Aerosol-Technology-Lab/IoT-Smart-Hydroponics-Greenhouse-Research/README.md

# IoT-Smart-Hydroponics-Greenhouse-Research
Smart Hydroponics Greenhouse for BAEN Research
