Aerosol-Technology-Lab/IoT-Smart-Hydroponics-Greenhouse-Research/pcb/mainboard-small/mainboard.xlsx

Prj: | Main | Hydroponics Mainboard |  |  |  |  | Board Qty: | 100
Co.: | Aerosol Technology Lab | Texas A&M University @ College Station, TX |  |  |  |  | Unit Cost: | $0.00
Prj date: | Fri 22 Oct 2021 12:01:29 PM CDT |  |  |  |  | Total Cost: | $0.00 |  |  |  |  | $0.00 | 0 of 42 parts found
$ date: | 2021-10-22 12:02:37
Global Part Info |  |  |  |  |  |  |  | Digi-Key
Refs | Value | Footprint | Manf | Manf# | Qty | Unit$ | Ext$ | Avail | Purch | Unit$ | MOQ | Ext$ | Cat#
C1-C3,C7-C9,C15 | 10uF | C_0805_2012Metric | CL21B106KOQNNNG |  | 700
C5,C11-C13,C16 | 0.1uF | C_0603_1608Metric | C0603C104J4RAC7867 | C0603C104J4RAC7867 | 500
H1,H2 | MountingHole | MountingHole_3.2mm_M3_ISO7380_Pad_TopOnly | - | - | 200
H3-H5 | MountingHole_Pad | MountingHole_3.2mm_M3_Pad_Via | - | - | 300
H6,H7 | MountingHole_Pad | MountingHole_4.3mm_M4_Pad_Via | - | - | 200
J1 | MC Comms Header | PinSocket_1x06_P2.54mm_Vertical | PPTC061LFBN-RC | PPTC061LFBN-RC | 100
J2 | 3.3V Breakout | PinSocket_1x08_P2.54mm_Vertical | - | - | 100
J3 | MC Digital HEADER | PinSocket_1x06_P2.54mm_Vertical | PPTC061LFBN-RC | PPTC061LFBN-RC (https://www.digikey.com/en/products/detail/sullins-connector-solutions/PPTC061LFBN-RC/810145) | 100
J4 | 5V Breakout | PinSocket_1x08_P2.54mm_Vertical | - | - | 100
J5 | MC_PWR | PinHeader_1x06_P2.54mm_Vertical | PPTC061LFBN-RC | PPTC061LFBN-RC | 100
J6 | MC Digital GPIO | PinSocket_1x06_P2.54mm_Vertical | PPTC061LFBN-RC | PPTC061LFBN-RC (https://www.digikey.com/en/products/detail/sullins-connector-solutions/PPTC061LFBN-RC/810145) | 100
J7 | GND Breakout | PinSocket_1x08_P2.54mm_Vertical |  | - | 100
J8 | MC Comms Breakout | PinHeader_1x06_P2.54mm_Vertical | PPTC061LFBN-RC | PPTC061LFBN-RC | 100
J9,J11 | BUS Breakout | PinHeader_2x04_P2.54mm_Vertical | - | - | 200
J10 | 5V Fan Header | PinHeader_1x02_P2.54mm_Vertical | - | - | 100
J12 | CP_2035551012 | MOLEX_2035551012 | 2035551012 | 2035551012 | 100
J13 | Chamber 1 | MTJ-889X1-FSE(RJ45) | MTJ-889X1-FSE | MODULAR JACK RJ45 8P8C | 100
J14 | Chamber 2 | MTJ-889X1-FSE(RJ45) | MTJ-889X1-FSE | MODULAR JACK RJ45 8P8C | 100
J15 | Chamber 3 | MTJ-889X1-FSE(RJ45) | MTJ-889X1-FSE | MODULAR JACK RJ45 8P8C | 100
J17 | RTC Module | PinSocket_1x06_P2.54mm_Vertical | PPTC061LFBN-RC | PPTC061LFBN-RC | 100
J18 | Raspberry Pi | IDC-Header_2x20_P2.54mm_Vertical | 3020-20-0100-00 | 3020-20-0100-00 | 100
J21 | +12V In | YK7010223000G(2POS-Terminal-Block) | YK7010223000G | YK7010223000G (https://www.digikey.com/en/htmldatasheets/production/1638528/0/0/1/yk701xx2x0j0g-drawing.html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) | 100
JP1 | SolderJumper_2_Open | SolderJumper-2_P1.3mm_Open_TrianglePad1.0x1.5mm | - | - | 100
JP2 | SCL_SELECT | SolderJumper-3_P1.3mm_Bridged12_Pad1.0x1.5mm | - | - | 100
JP3 | MC 3.3V | SolderJumper-2_P1.3mm_Bridged2Bar_Pad1.0x1.5mm | - | - | 100
JP4 | RPi-Reset_EN | SolderJumper-2_P1.3mm_Open_TrianglePad1.0x1.5mm | - | - | 100
JP5 | SDA_SELECT | SolderJumper-3_P1.3mm_Bridged12_Pad1.0x1.5mm | - | - | 100
JP6 | PI-RTC_PWR_EN | SolderJumper-2_P1.3mm_Open_TrianglePad1.0x1.5mm | - | - | 100
JP7 | Earth Ground-Signal Groud Bridge | SolderJumper-2_P1.3mm_Open_TrianglePad1.0x1.5mm | - | - | 100
JP8,JP9 | SolderJumper_2_Open | SolderJumper-2_P1.3mm_Open_Pad1.0x1.5mm | - | - | 200
Q1 | DMG3402L | SOT-23 | DMG3402L-7 | DMG3402L-7 (http://www.diodes.com/assets/Datasheets/DMG3402L.pdf) | 100
Q2 | RD3L07BAT | TO-252-2 | RD3L03BATTL1 | RD3L03BATTL1 (https://fscdn.rohm.com/en/products/databook/datasheet/discrete/transistor/mosfet/rd3l07battl1-e.pdf) | 100
R1,R3,R17,R18 | 4.7k | R_0603_1608Metric | RMCF0603FT4K70 |  | 400
R2 | 120R | R_0603_1608Metric | RC0603FR-07120RL |  | 100
R4,R6,R9-R14 | 10k | R_0603_1608Metric | RMCF0603FT10K0 |  | 800
R5 | 1k | R_0603_1608Metric | RC0603FR-071KL |  | 100
R19,R21 | 100k | R_0603_1608Metric | RC0603FR-07100KL |  | 200
R20,R22 | 100R | R_0603_1608Metric | RC0603FR-07100RL |  | 200
S1 | PTS636-SMG25J-SMTR-LFS | PTS636SK50SMTRLFS |  | - (https://www.ckswitches.com/media/2779/pts636.pdf) | 100
U2 | PCA9548ADB | SSOP-24_5.3x8.2mm_P0.65mm | PCA9548ADB | PCA9548ADB (http://www.ti.com/lit/ds/symlink/pca9548a.pdf) | 100
U3-U5 | LTC4311CSC6#TRPBF | SOT-363_SC-70-6 | LTC4311CSC6#TRPBF | LTC4311CSC6#TRPBF (https://www.analog.com/media/en/technical-documentation/data-sheets/4311fa.pdf) | 300
U7 | DFRobot-5V-Regulator | DFRobot-5V-Regulator | - | - | 100
 |  |  |  |  |  | Total Purchase: | $0.00 | Buy here (https://www.digikey.com/ordering/shoppingcart) |  |  |  | $0.00
KiCost® v1.1.6 |  |  |  |  |  | Purchase description:
