Aerosol-Technology-Lab/IoT-Smart-Hydroponics-Greenhouse-Research/pcb/mainboard-small/models/duraclik-3pos.stp

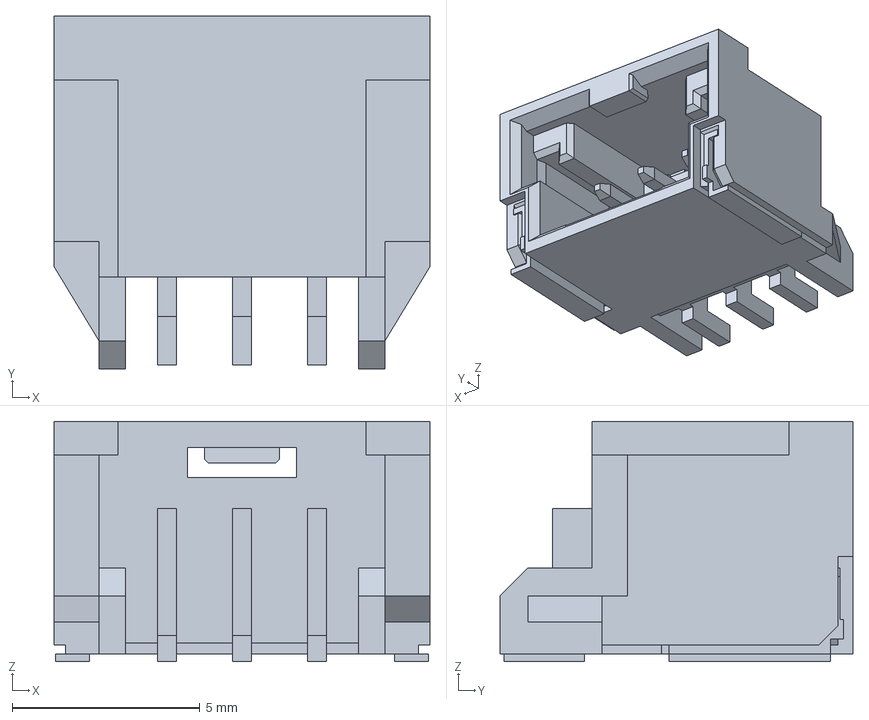
[picture p1: CAD file, 2022-02-17]
pcb/mainboard-small/models/duraclik-3pos.stp
10.00 x 9.40 x 6.40 mm
