Aerosol-Technology-Lab/IoT-Smart-Hydroponics-Greenhouse-Research/pcb/mainboard/models/MTJ-889X1-FSE.stp

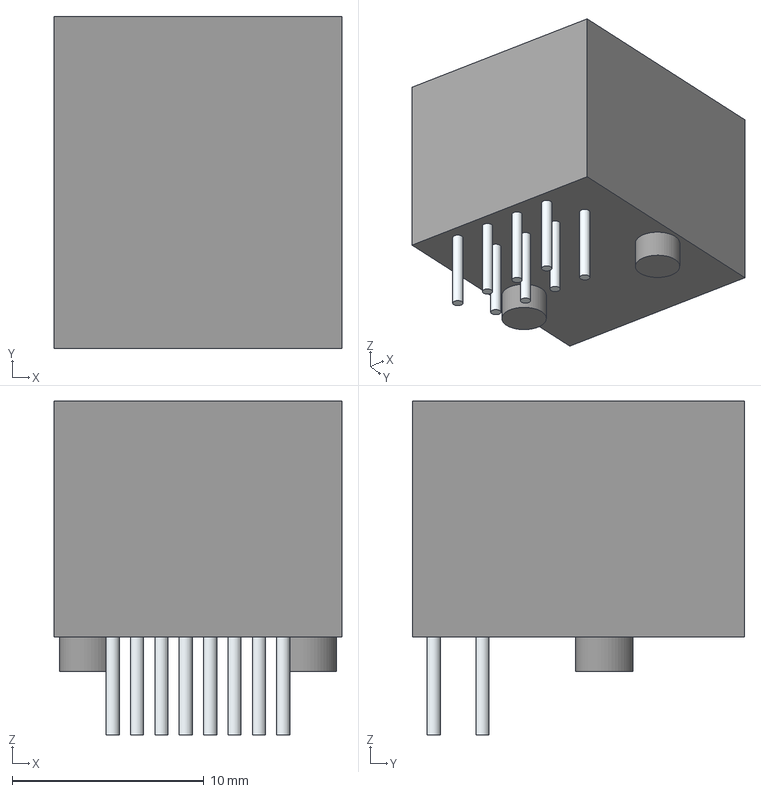
[picture p2: CAD file, 2022-02-17]
pcb/mainboard/models/MTJ-889X1-FSE.stp
15.0 x 17.3 x 17.4 mm
Lugs x 10
Leads x 10
