Aerosol-Technology-Lab/IoT-Smart-Hydroponics-Greenhouse-Research/pcb/mainboard-small/models/duraclik-4pos-nat.stp

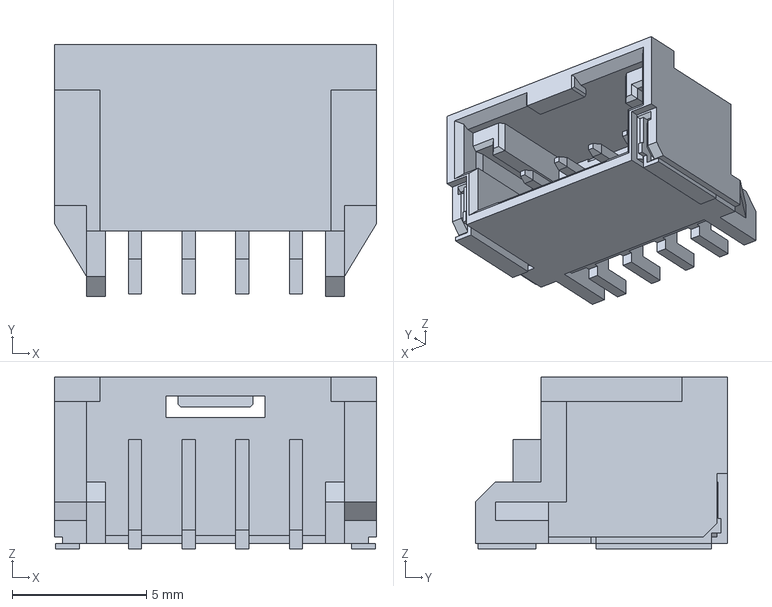
[picture p3: CAD file, 2022-02-17]
pcb/mainboard-small/models/duraclik-4pos-nat.stp
12.0 x 9.40 x 6.40 mm
