Aerosol-Technology-Lab/IoT-Smart-Hydroponics-Greenhouse-Research/pcb/mainboard-small/models/5054133410.stp

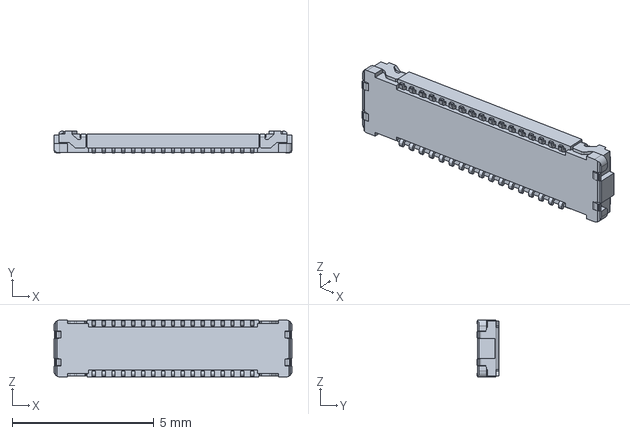
[picture p4: CAD file, 2022-02-17]
pcb/mainboard-small/models/5054133410.stp
8.40 x 0.78 x 2.00 mm
