Aerosol-Technology-Lab/IoT-Smart-Hydroponics-Greenhouse-Research/pcb/mainboard/models/955016449.stp

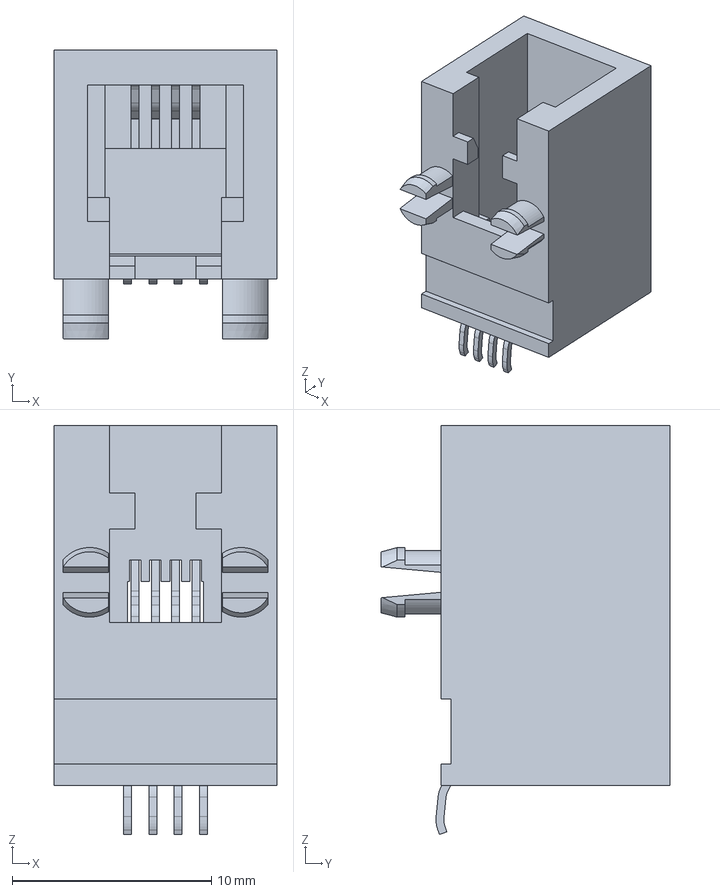
[picture p5: CAD file, 2022-02-17]
pcb/mainboard/models/955016449.stp
11.2 x 14.5 x 20.6 mm
