Aerosol-Technology-Lab/IoT-Smart-Hydroponics-Greenhouse-Research/pcb/mainboard-small/models/022053031.stp

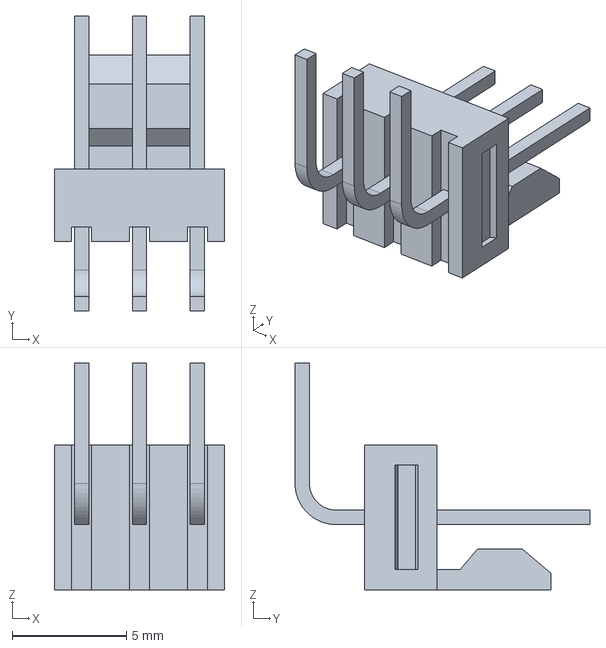
[picture p6: CAD file, 2022-02-17]
pcb/mainboard-small/models/022053031.stp
7.47 x 12.9 x 9.93 mm
