Aerosol-Technology-Lab/IoT-Smart-Hydroponics-Greenhouse-Research/pcb/mainboard-small/models/2035551012.step

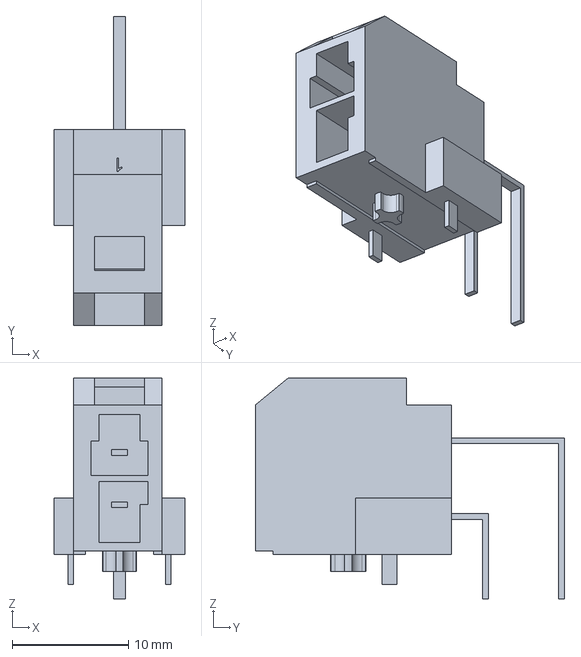
[picture p7: CAD file, 2022-02-17]
pcb/mainboard-small/models/2035551012.step
11.3 x 26.6 x 19.0 mm
