Aerosol-Technology-Lab/IoT-Smart-Hydroponics-Greenhouse-Research/(list of files, cad)

Other CAD files:
pcb/mainboard-small/models/duraclik-4pos-black.stp
