Aerosol-Technology-Lab/IoT-Smart-Hydroponics-Greenhouse-Research/pcb/mainboard-small/mainboard.kicad_pcb

## KiCad design pcb/mainboard-small/mainboard.kicad_pcb (2022-02-17)

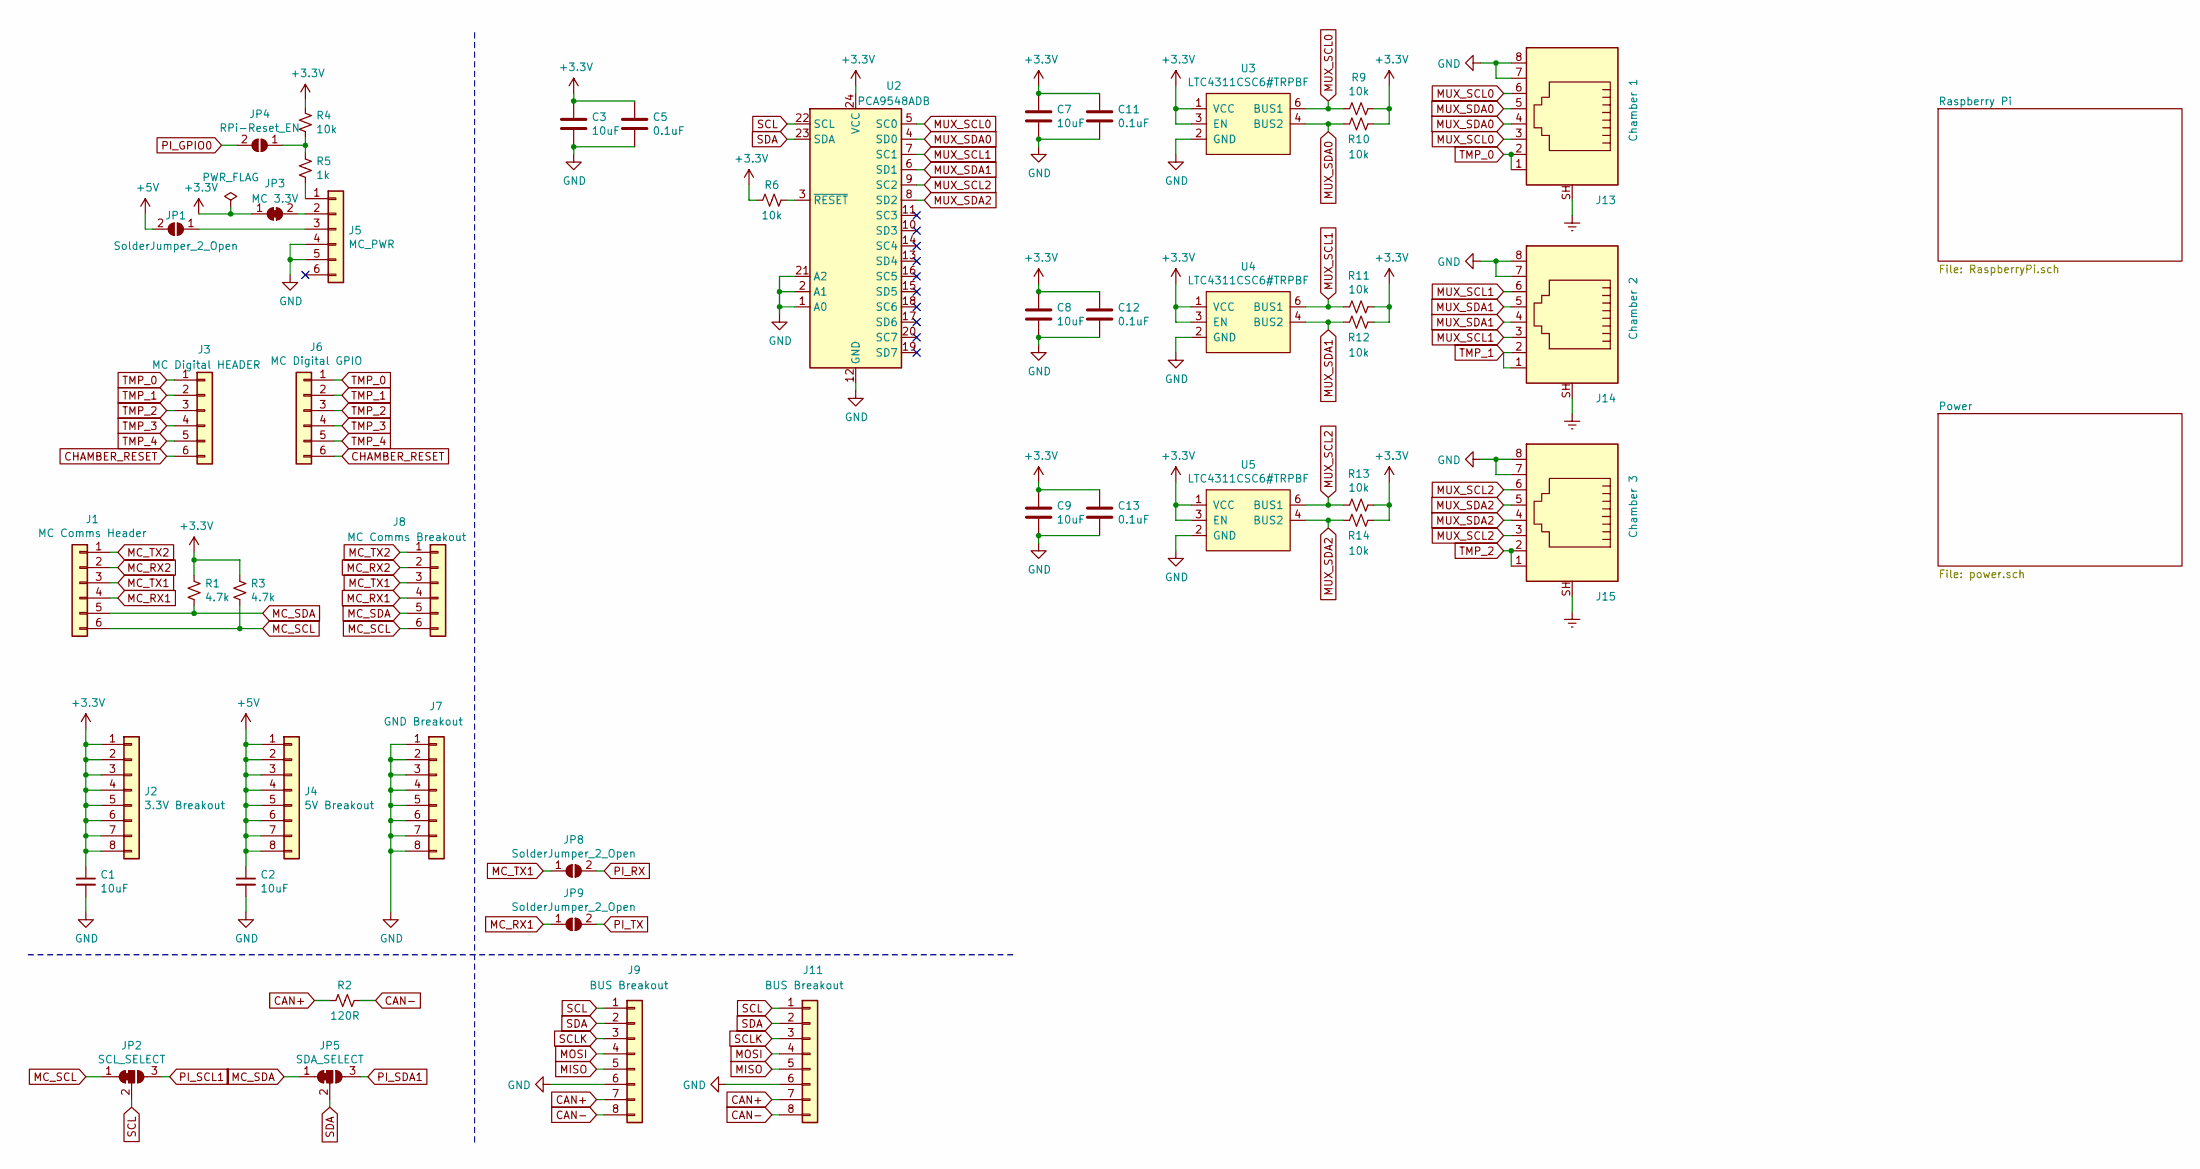
[picture p8: schematic mainboard.sch, Main | Hydroponics Mainboard]

Parts:
C1, C2, C3, C7, C8, C9: 10uF; C_0805_2012Metric
C5, C11, C12, C13: 0.1uF; C_0603_1608Metric
J1: MC Comms Header; PinSocket_1x06_P2.54mm_Vertical
J2: 3.3V Breakout; PinSocket_1x08_P2.54mm_Vertical
J3: MC Digital HEADER; PinSocket_1x06_P2.54mm_Vertical
J4: 5V Breakout; PinSocket_1x08_P2.54mm_Vertical
J5: MC_PWR; PinHeader_1x06_P2.54mm_Vertical
J6: MC Digital GPIO; PinSocket_1x06_P2.54mm_Vertical
J7: GND Breakout; PinSocket_1x08_P2.54mm_Vertical
J8: MC Comms Breakout; PinHeader_1x06_P2.54mm_Vertical
J9, J11: BUS Breakout; PinHeader_2x04_P2.54mm_Vertical
J13: Chamber 1; MTJ-889X1-FSE(RJ45)
J14: Chamber 2; MTJ-889X1-FSE(RJ45)
J15: Chamber 3; MTJ-889X1-FSE(RJ45)
JP1: SolderJumper_2_Open; SolderJumper-2_P1.3mm_Open_TrianglePad1.0x1.5mm
JP2: SCL_SELECT; SolderJumper-3_P1.3mm_Bridged12_Pad1.0x1.5mm
JP3: MC 3.3V; SolderJumper-2_P1.3mm_Bridged2Bar_Pad1.0x1.5mm
JP4: RPi-Reset_EN; SolderJumper-2_P1.3mm_Open_TrianglePad1.0x1.5mm
JP5: SDA_SELECT; SolderJumper-3_P1.3mm_Bridged12_Pad1.0x1.5mm
JP8, JP9: SolderJumper_2_Open; SolderJumper-2_P1.3mm_Open_Pad1.0x1.5mm
R1, R3: 4.7k; R_0603_1608Metric
R2: 120R; R_0603_1608Metric
R4, R6, R9, R10, R11, R12, R13, R14: 10k; R_0603_1608Metric
R5: 1k; R_0603_1608Metric
U2: PCA9548ADB; SSOP-24_5.3x8.2mm_P0.65mm
U3, U4, U5: LTC4311CSC6#TRPBF; SOT-363_SC-70-6

Connections:
+3V3: C1.1, C3.1, C5.1, C7.1, C8.1, C9.1, C11.1, C12.1, C13.1, J2.1, J2.2, J2.3, J2.4, J2.5, J2.6, J2.7, J2.8, JP3.1 (A), R1.1, R3.1, R4.1, R6.2, R9.1, R10.1, R11.1, R12.1, R13.1, R14.1, U2.24 (VCC), U3.1 (VCC), U3.3 (EN), U4.1 (VCC), U4.3 (EN), U5.1 (VCC), U5.3 (EN); also elsewhere on the board
+5V: C2.1, J4.1, J4.2, J4.3, J4.4, J4.5, J4.6, J4.7, J4.8, JP1.2 (B); also elsewhere on the board
CAN+: J9.7, J11.7, R2.1
CAN-: J9.8, J11.8, R2.2
CHAMBER_RESET: J3.6, J6.6; also elsewhere on the board
Earth: J13.SH, J14.SH, J15.SH; also elsewhere on the board
GND: C1.2, C2.2, C3.2, C5.2, C7.2, C8.2, C9.2, C11.2, C12.2, C13.2, J5.4, J5.5, J7.1, J7.2, J7.3, J7.4, J7.5, J7.6, J7.7, J7.8, J9.6, J11.6, J13.7, J13.8, J14.7, J14.8, J15.7, J15.8, U2.1 (A0), U2.2 (A1), U2.12 (GND), U2.21 (A2), U3.2 (GND), U3.5 (GND), U4.2 (GND), U4.5 (GND), U5.2 (GND), U5.5 (GND); also elsewhere on the board
MC_RX1: J1.4, J8.4, JP9.1 (A)
MC_RX2: J1.2, J8.2
MC_SCL: J1.6, J8.6, JP2.1 (A), R3.2
MC_SDA: J1.5, J8.5, JP5.1 (A), R1.2
MC_TX1: J1.3, J8.3, JP8.1 (A)
MC_TX2: J1.1, J8.1
MISO: J9.5, J11.5
MOSI: J9.4, J11.4
MUX_SCL0: J13.3, J13.6, R9.2, U2.5 (SC0), U3.6 (BUS1)
MUX_SCL1: J14.3, J14.6, R11.2, U2.7 (SC1), U4.6 (BUS1)
MUX_SCL2: J15.3, J15.6, R13.2, U2.9 (SC2), U5.6 (BUS1)
MUX_SDA0: J13.4, J13.5, R10.2, U2.4 (SD0), U3.4 (BUS2)
MUX_SDA1: J14.4, J14.5, R12.2, U2.6 (SD1), U4.4 (BUS2)
MUX_SDA2: J15.4, J15.5, R14.2, U2.8 (SD2), U5.4 (BUS2)
unnamed: J5.1, R5.2
unnamed: J5.2, JP3.2 (B)
unnamed: J5.3, JP1.1 (A)
unnamed: JP4.1 (A), R4.2, R5.1
unnamed: R6.1, U2.3 (~RESET)
PI_GPIO0: JP4.2 (B); also elsewhere on the board
PI_RX: JP8.2 (B); also elsewhere on the board
PI_SCL1: JP2.3 (B); also elsewhere on the board
PI_SDA1: JP5.3 (B); also elsewhere on the board
PI_TX: JP9.2 (B); also elsewhere on the board
SCL: J9.1, J11.1, JP2.2 (C), U2.22 (SCL)
SCLK: J9.3, J11.3
SDA: J9.2, J11.2, JP5.2 (C), U2.23 (SDA)
TMP_0: J3.1, J6.1, J13.1, J13.2
TMP_1: J3.2, J6.2, J14.1, J14.2
TMP_2: J3.3, J6.3, J15.1, J15.2
TMP_3: J3.4, J6.4
TMP_4: J3.5, J6.5

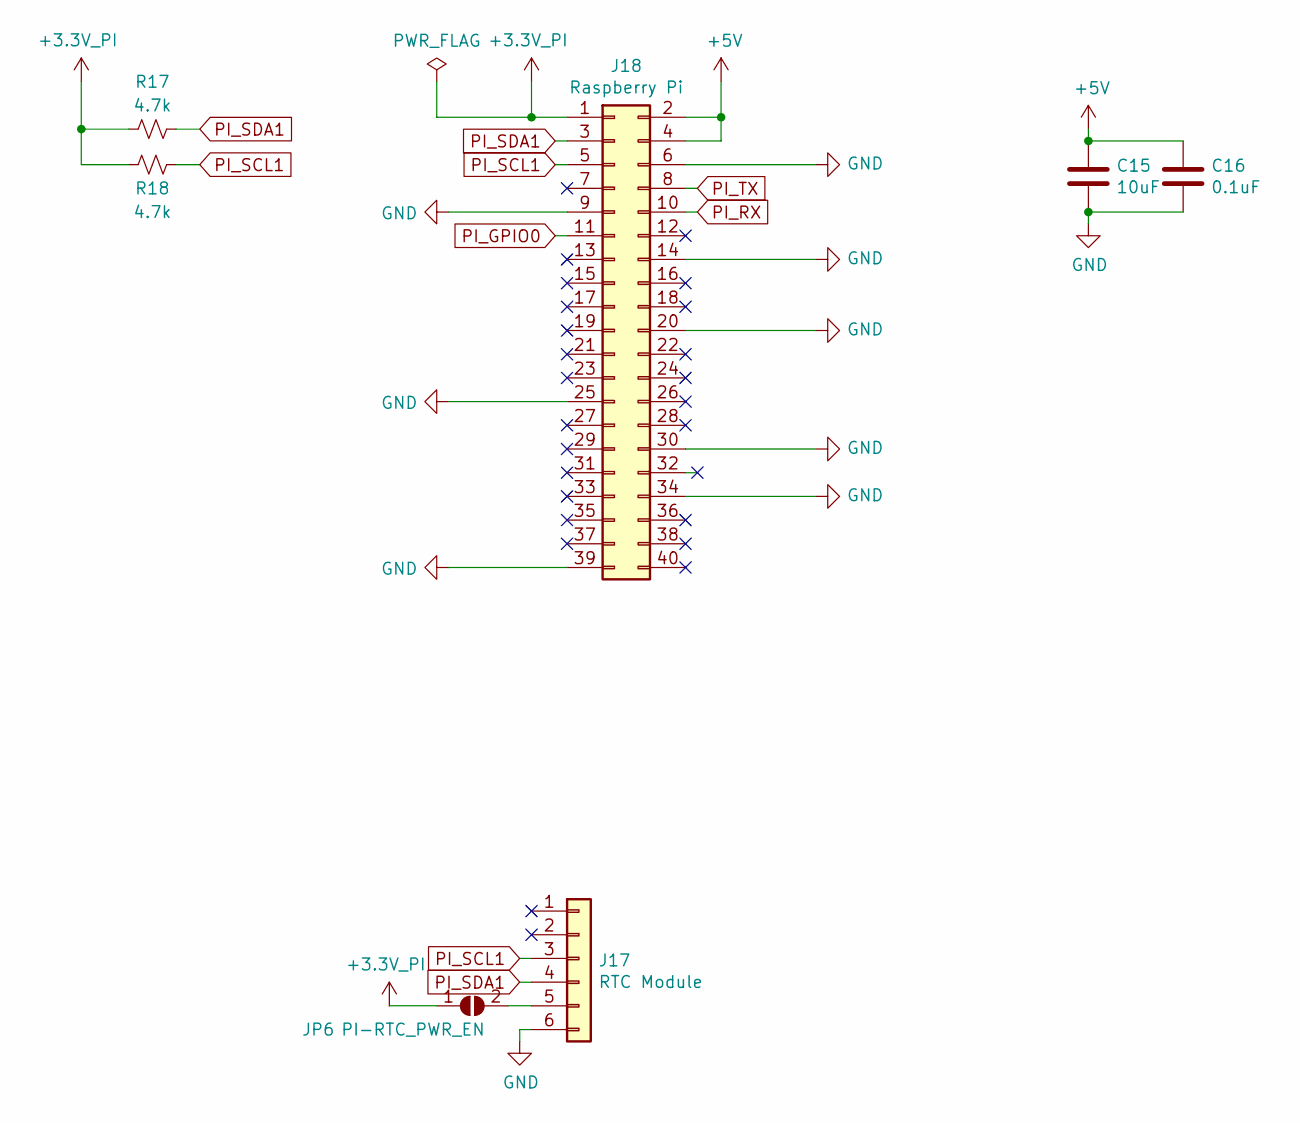
[picture p9: schematic RaspberryPi.sch, Raspberry Pi Connection | Hydroponics Mainboard]

Parts:
C15: 10uF; C_0805_2012Metric
C16: 0.1uF; C_0603_1608Metric
J17: RTC Module; PinSocket_1x06_P2.54mm_Vertical
J18: Raspberry Pi; IDC-Header_2x20_P2.54mm_Vertical
JP6: PI-RTC_PWR_EN; SolderJumper-2_P1.3mm_Open_TrianglePad1.0x1.5mm
R17, R18: 4.7k; R_0603_1608Metric

Connections:
+5V: C15.1, C16.1, J18.2, J18.4; also elsewhere on the board
GND: C15.2, C16.2, J17.6, J18.6, J18.9, J18.14, J18.20, J18.25, J18.30, J18.34, J18.39; also elsewhere on the board
unnamed: J17.5, JP6.2 (B)
PI_GPIO0: J18.11; also elsewhere on the board
PI_RX: J18.10; also elsewhere on the board
PI_SCL1: J17.3, J18.5, R18.1; also elsewhere on the board
PI_SDA1: J17.4, J18.3, R17.1; also elsewhere on the board
PI_TX: J18.8; also elsewhere on the board
~: J18.1, JP6.1 (A), R17.2, R18.2

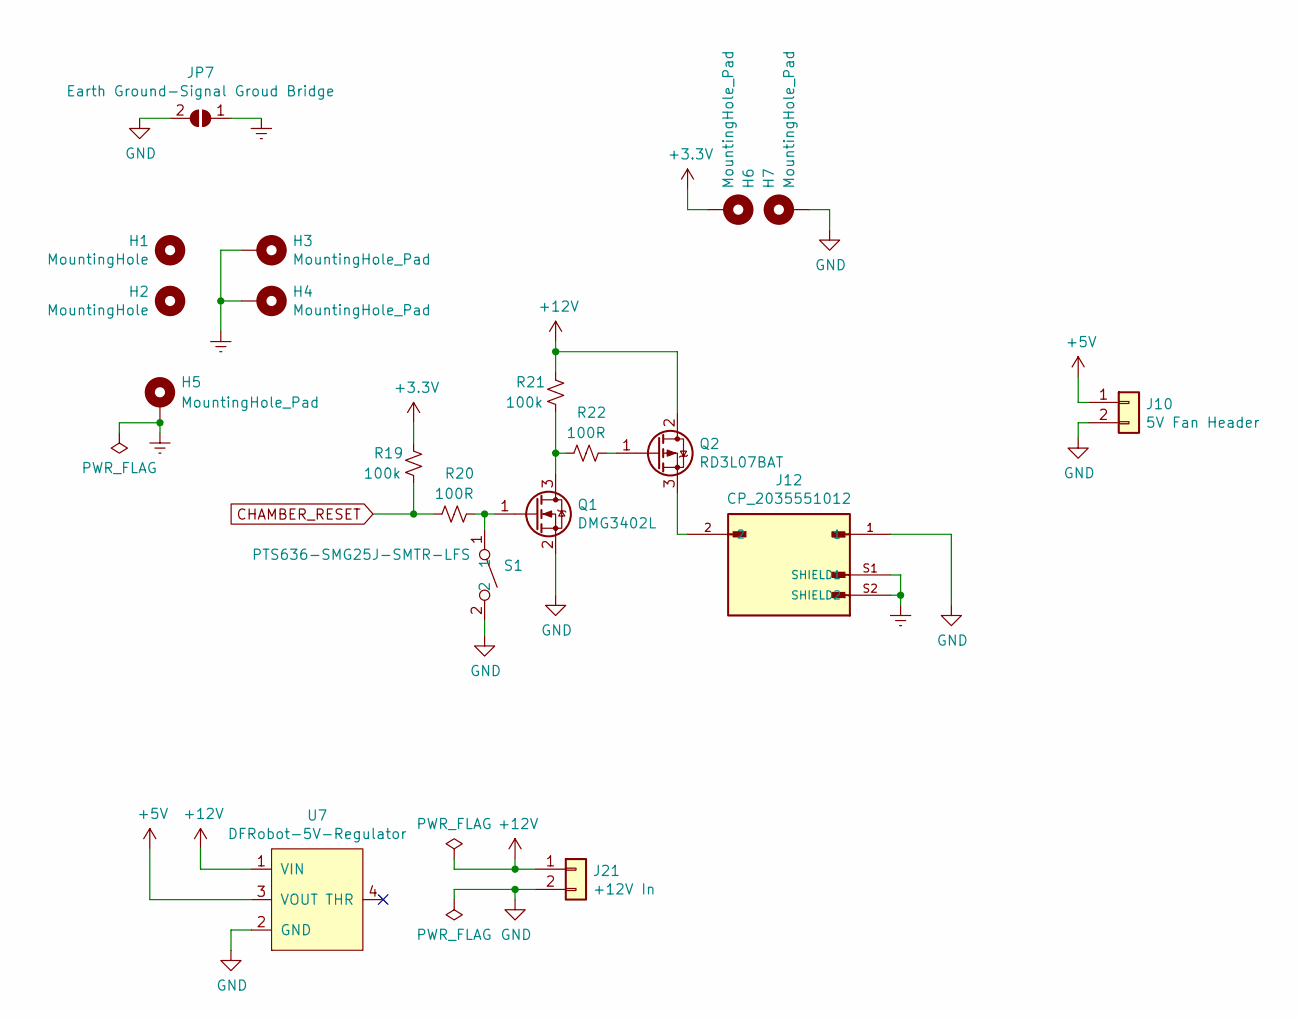
[picture p10: schematic power.sch, Power Regulator | Hydroponics Mainboard]

Parts:
H1, H2: MountingHole; MountingHole_3.2mm_M3_ISO7380_Pad_TopOnly
H3, H4, H5: MountingHole_Pad; MountingHole_3.2mm_M3_Pad_Via
H6, H7: MountingHole_Pad; MountingHole_4.3mm_M4_Pad_Via
J10: 5V Fan Header; PinHeader_1x02_P2.54mm_Vertical
J12: CP_2035551012; MOLEX_2035551012; PARTREV A1
J21: +12V In; YK7010223000G(2POS-Terminal-Block)
JP7: Earth Ground-Signal Groud Bridge; SolderJumper-2_P1.3mm_Open_TrianglePad1.0x1.5mm
Q1: DMG3402L; SOT-23
Q2: RD3L07BAT; TO-252-2
R19, R21: 100k; R_0603_1608Metric
R20, R22: 100R; R_0603_1608Metric
S1: PTS636-SMG25J-SMTR-LFS; PTS636SK50SMTRLFS
U7: DFRobot-5V-Regulator

Connections:
+3V3: H6.1, R19.1; also elsewhere on the board
+5V: J10.1, U7.3 (VOUT); also elsewhere on the board
+12V: J21.1, Q2.2 (D), R21.1, U7.1 (VIN)
CHAMBER_RESET: R19.2, R20.2; also elsewhere on the board
Earth: H3.1, H4.1, H5.1, J12.S1 (SHIELD1), J12.S2 (SHIELD2), JP7.1 (A); also elsewhere on the board
GND: H7.1, J10.2, J12.1, J21.2, JP7.2 (B), Q1.2 (S), S1.2, U7.2 (GND); also elsewhere on the board
unnamed: J12.2, Q2.3 (S)
unnamed: Q1.1 (G), R20.1, S1.1
unnamed: Q1.3 (D), R21.2, R22.2
unnamed: Q2.1 (G), R22.1

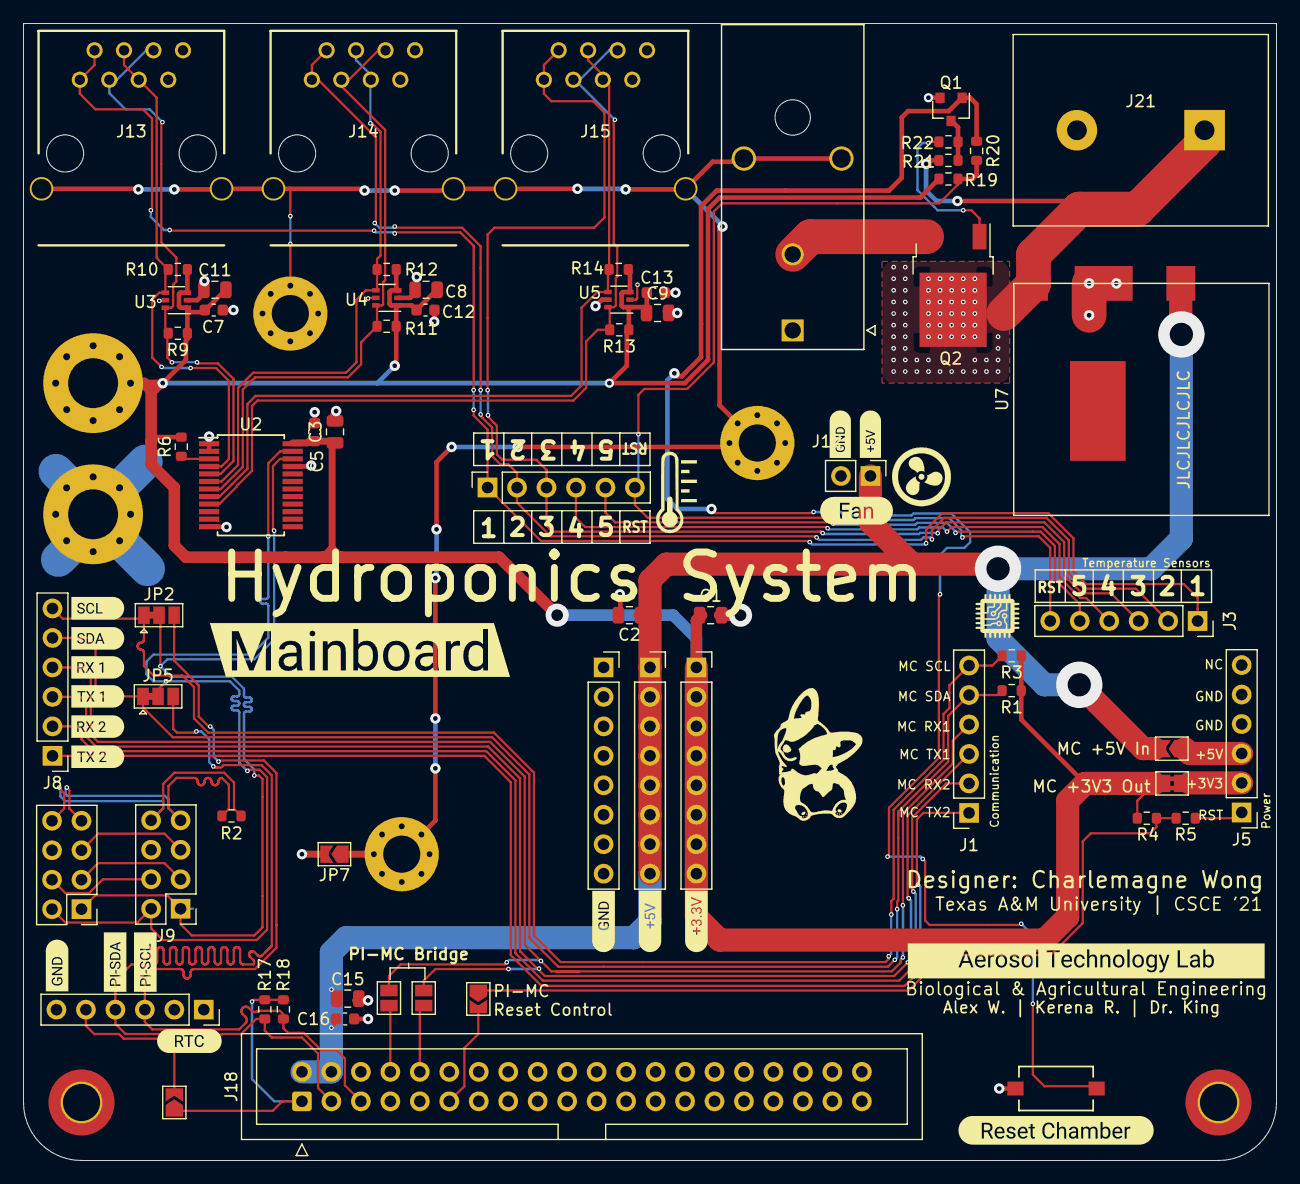
[picture p11: board pcb/mainboard-small/mainboard.kicad_pcb from above]

Board: 2 copper layers, 108.0 x 98.0 mm, 92 parts (1 on the bottom side), 46 nets.

Other parts of the board:
QR*****: Website
kibuzzard-616F51D1, kibuzzard-6170A1A7, kibuzzard-6170A2EA, kibuzzard-6170A2EF, kibuzzard-6170A2F3, kibuzzard-6170A2F8, kibuzzard-6170A2FD, kibuzzard-6170A21A, kibuzzard-6170A145, kibuzzard-6170A234, kibuzzard-6170A301, kibuzzard-6170BBF0, kibuzzard-6170FF3B, kibuzzard-6170FFCB, kibuzzard-6170FFCF, kibuzzard-61707D3E, kibuzzard-61707D37, kibuzzard-61707DB8, kibuzzard-61710606: G***; label
