Aerosol-Technology-Lab/IoT-Smart-Hydroponics-Greenhouse-Research/pcb/chamber-board/chamber-board.kicad_pcb

## KiCad design pcb/chamber-board/chamber-board.kicad_pcb (2022-02-17)

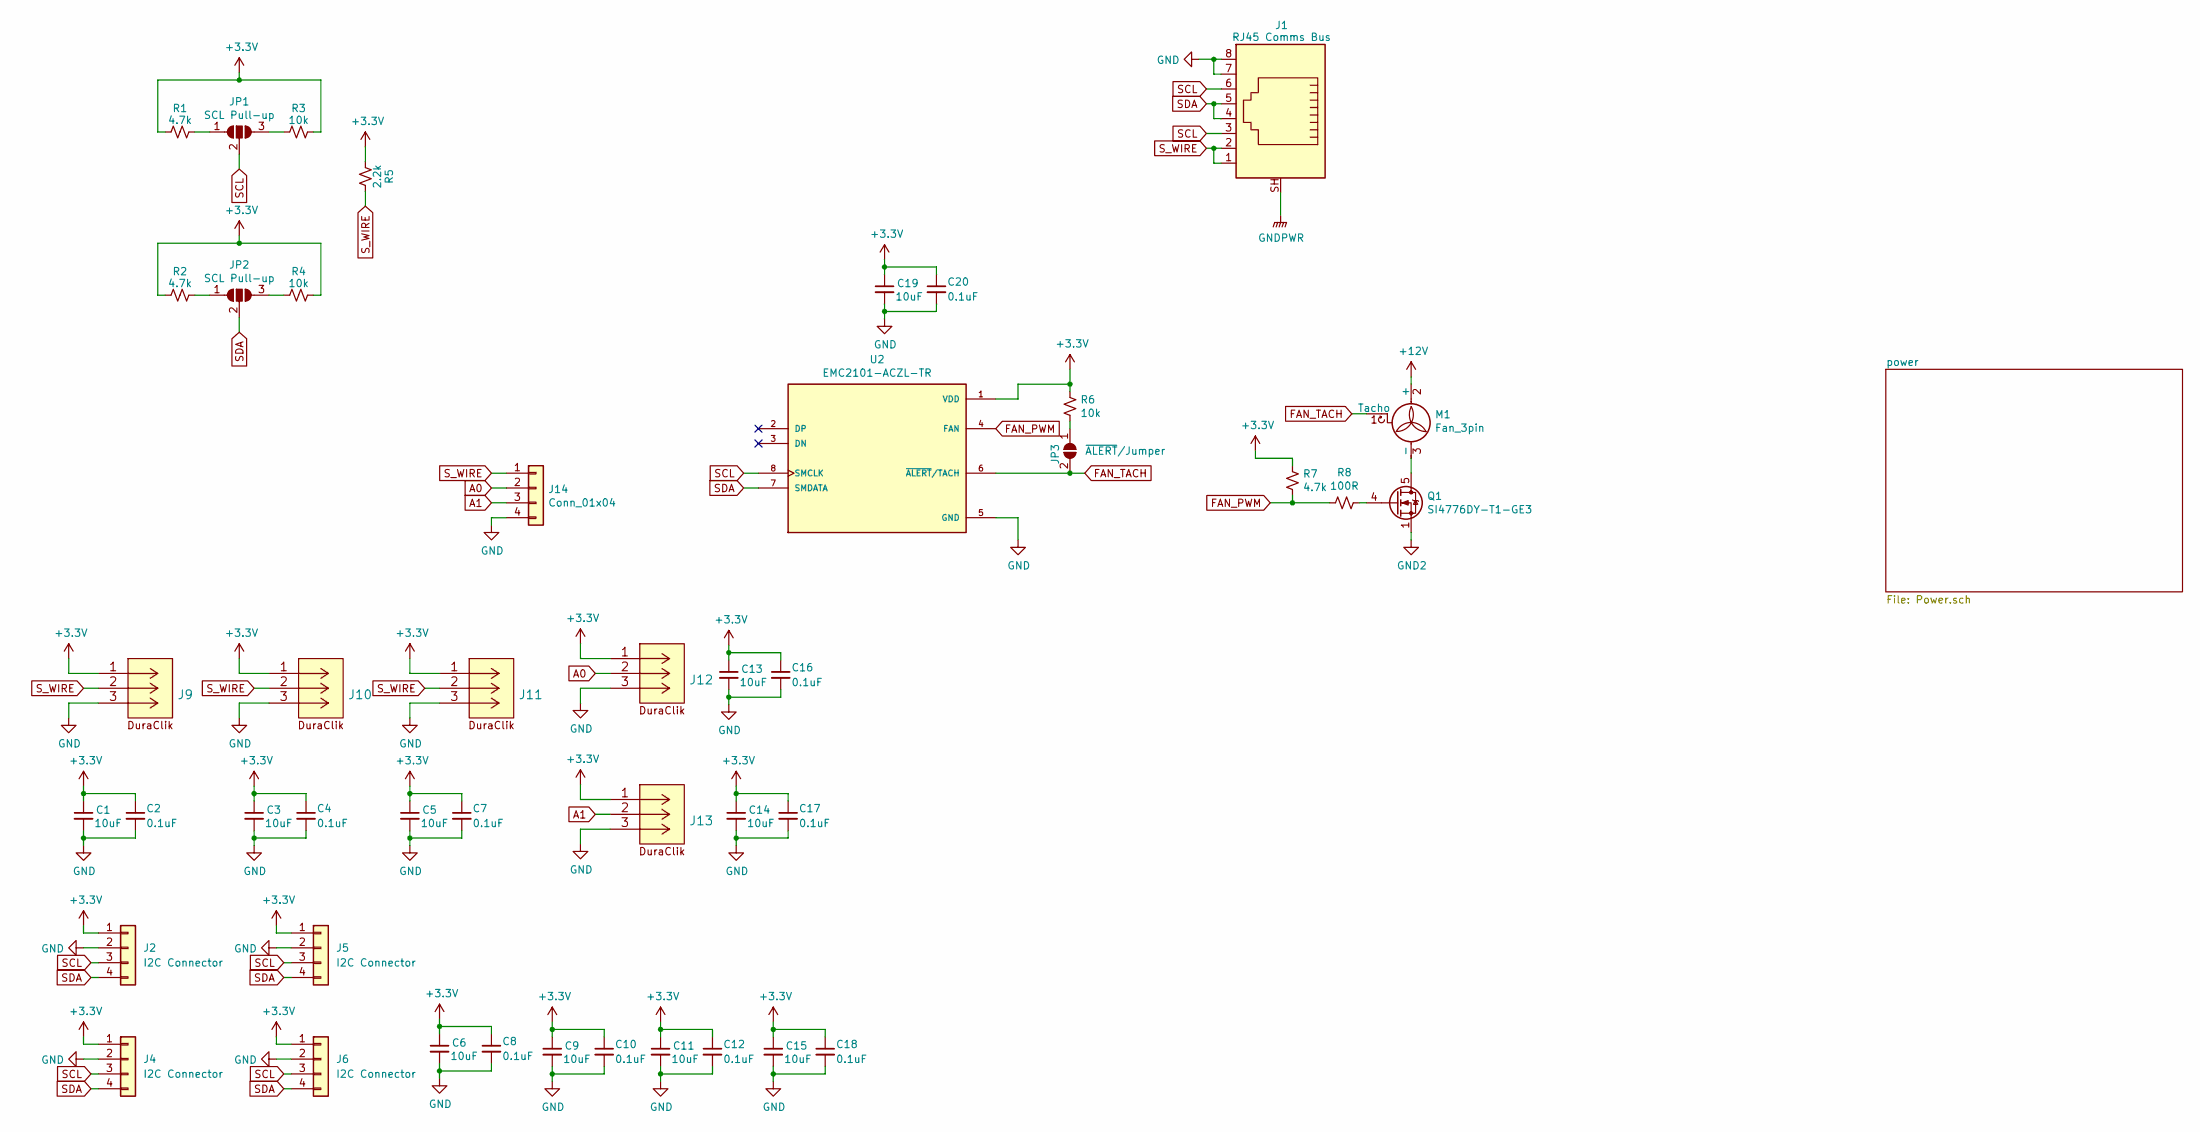
[picture p12: schematic chamber-board.sch, Hydroponics System - Chamber Controller]

Parts:
C1, C3, C5, C6, C9, C11, C13, C14, C15, C19: 10uF; C_0805_2012Metric
C2, C4, C7, C8, C10, C12, C16, C17, C18, C20: 0.1uF; C_0603_1608Metric
J1: RJ45 Comms Bus; MTJ-889X1-FSE(RJ45)
J2, J4, J5, J6: I2C Connector; duraclik-4pos
J9, J10, J11, J12, J13: 5023520300(DuraClik-3pos); duraclik-3pos
J14: Conn_01x04; PinHeader_1x04_P2.54mm_Vertical
JP1, JP2: SCL Pull-up; SolderJumper-3_P2.0mm_Open_TrianglePad1.0x1.5mm
JP3: ~ALERT~/Jumper; SolderJumper-2_P1.3mm_Open_TrianglePad1.0x1.5mm
M1: Fan_3pin; 3pin-fanheader
Q1: SI4776DY-T1-GE3
R1, R2, R7: 4.7k; R_0603_1608Metric
R3, R4, R6: 10k; R_0603_1608Metric
R5: 2.2k; R_0603_1608Metric
R8: 100R; R_0603_1608Metric
U2: EMC2101-ACZL-TR; PARTREV 2.54(06-16-09)

Connections:
+3V3: C1.1, C2.1, C3.1, C4.1, C5.1, C6.1, C7.1, C8.1, C9.1, C10.1, C11.1, C12.1, C13.1, C14.1, C15.1, C16.1, C17.1, C18.1, C19.1, C20.1, J2.1, J4.1, J5.1, J6.1, J9.1, J10.1, J11.1, J12.1, J13.1, R1.2, R2.2, R3.1, R4.1, R5.2, R6.1, R7.1, U2.1 (VDD); also elsewhere on the board
+12V: M1.2 (+); also elsewhere on the board
A0: J12.2, J14.2
A1: J13.2, J14.3
FAN_PWM: R7.2, R8.2, U2.4 (FAN)
FAN_TACH: JP3.2 (B), M1.1 (Tacho), U2.6 (~ALERT~/TACH)
GND: C1.2, C2.2, C3.2, C4.2, C5.2, C6.2, C7.2, C8.2, C9.2, C10.2, C11.2, C12.2, C13.2, C14.2, C15.2, C16.2, C17.2, C18.2, C19.2, C20.2, J1.7, J1.8, J2.2, J4.2, J5.2, J6.2, J9.3, J10.3, J11.3, J12.3, J13.3, J14.4, U2.5 (GND); also elsewhere on the board
GND2: Q1.1 (S), Q1.2 (S), Q1.3 (S); also elsewhere on the board
GNDPWR: J1.SH; also elsewhere on the board
unnamed: JP1.1 (A), R1.1
unnamed: JP1.3 (B), R3.2
unnamed: JP2.1 (A), R2.1
unnamed: JP2.3 (B), R4.2
unnamed: JP3.1 (A), R6.2
unnamed: M1.3 (-), Q1.5 (D), Q1.6 (D), Q1.7 (D), Q1.8 (D)
unnamed: Q1.4 (G), R8.1
SCL: J1.3, J1.6, J2.3, J4.3, J5.3, J6.3, JP1.2 (C), U2.8 (SMCLK)
SDA: J1.4, J1.5, J2.4, J4.4, J5.4, J6.4, JP2.2 (C), U2.7 (SMDATA)
S_WIRE: J1.1, J1.2, J9.2, J10.2, J11.2, J14.1, R5.1

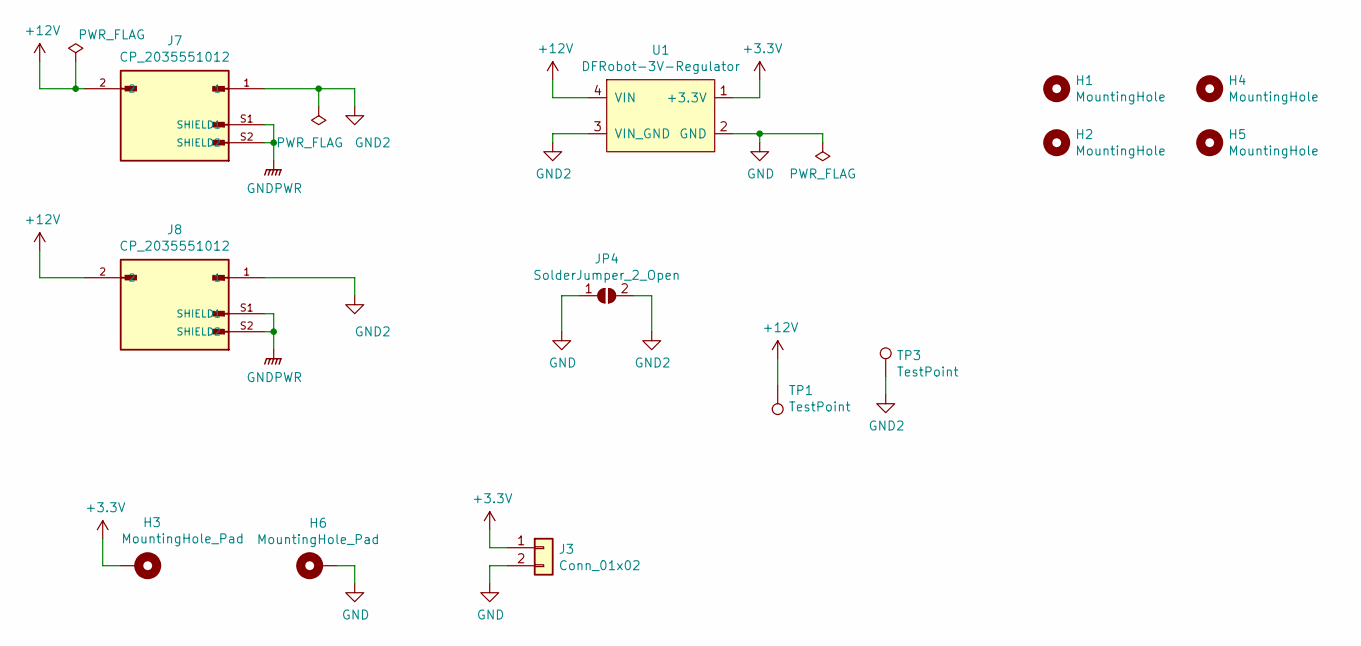
[picture p13: schematic Power.sch, Power | Hydroponics System - Chamber Controller]

Parts:
H1, H2, H4, H5: MountingHole; MountingHole_3.2mm_M3_DIN965_Pad_TopBottom
H3, H6: MountingHole_Pad; MountingHole_4.3mm_M4_Pad_Via
J3: Conn_01x02; PinSocket_1x02_P2.54mm_Vertical
J7, J8: CP_2035551012; MOLEX_2035551012; PARTREV A1
JP4: SolderJumper_2_Open; SolderJumper-2_P1.3mm_Open_Pad1.0x1.5mm
TP1, TP3: TestPoint; TestPoint_Pad_D1.5mm
U1: DFRobot-3V-Regulator; DFRobot-3VRegulator

Connections:
+3V3: H3.1, J3.1, U1.1 (+3.3V); also elsewhere on the board
+12V: J7.2, J8.2, TP1.1, U1.4 (VIN); also elsewhere on the board
GND: H6.1, J3.2, JP4.1 (A), U1.2 (GND); also elsewhere on the board
GND2: J7.1, J8.1, JP4.2 (B), TP3.1, U1.3 (VIN_GND); also elsewhere on the board
GNDPWR: J7.S1 (SHIELD1), J7.S2 (SHIELD2), J8.S1 (SHIELD1), J8.S2 (SHIELD2); also elsewhere on the board

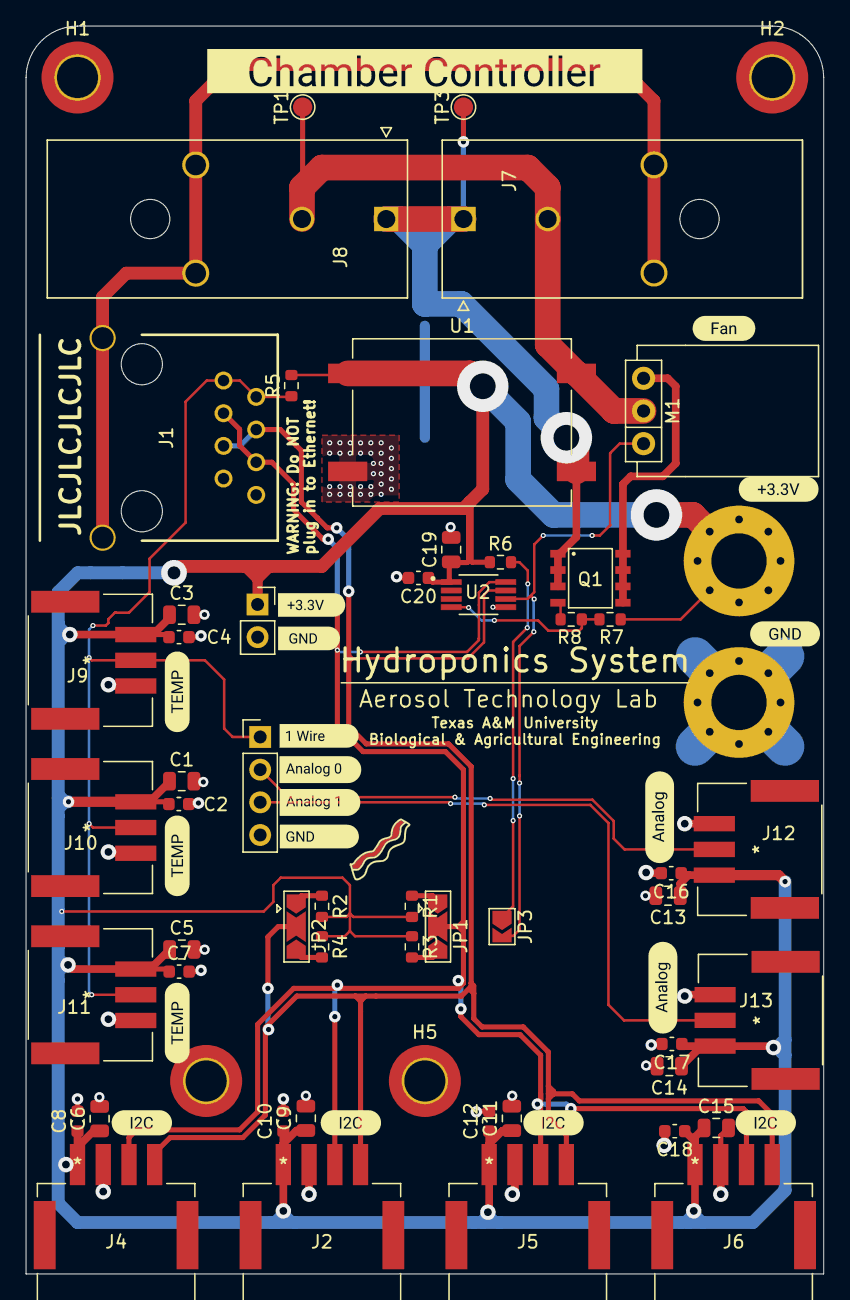
[picture p14: board chamber-board.kicad_pcb from above]

Board: 2 copper layers, 62.0 x 97.0 mm, 77 parts (1 on the bottom side), 19 nets.

Other parts of the board:
kibuzzard-61722B24, kibuzzard-61722E00, kibuzzard-61722E00#2, kibuzzard-61722EB4, kibuzzard-61722EB4#2, kibuzzard-61722EB4#3, kibuzzard-61722F03, kibuzzard-61722F03#2, kibuzzard-61722F03#3, kibuzzard-61722F03#4, kibuzzard-61722F58, kibuzzard-61722FB7, kibuzzard-61722FC6, kibuzzard-61723AEA, kibuzzard-61723AEE, kibuzzard-61723AF5, kibuzzard-61723AFD, kibuzzard-617232DF, kibuzzard-617232F2: G***; label
