Aerosol-Technology-Lab/IoT-Smart-Hydroponics-Greenhouse-Research/pcb/mainboard/mainboard.kicad_pcb

## KiCad design pcb/mainboard/mainboard.kicad_pcb (2022-02-17)

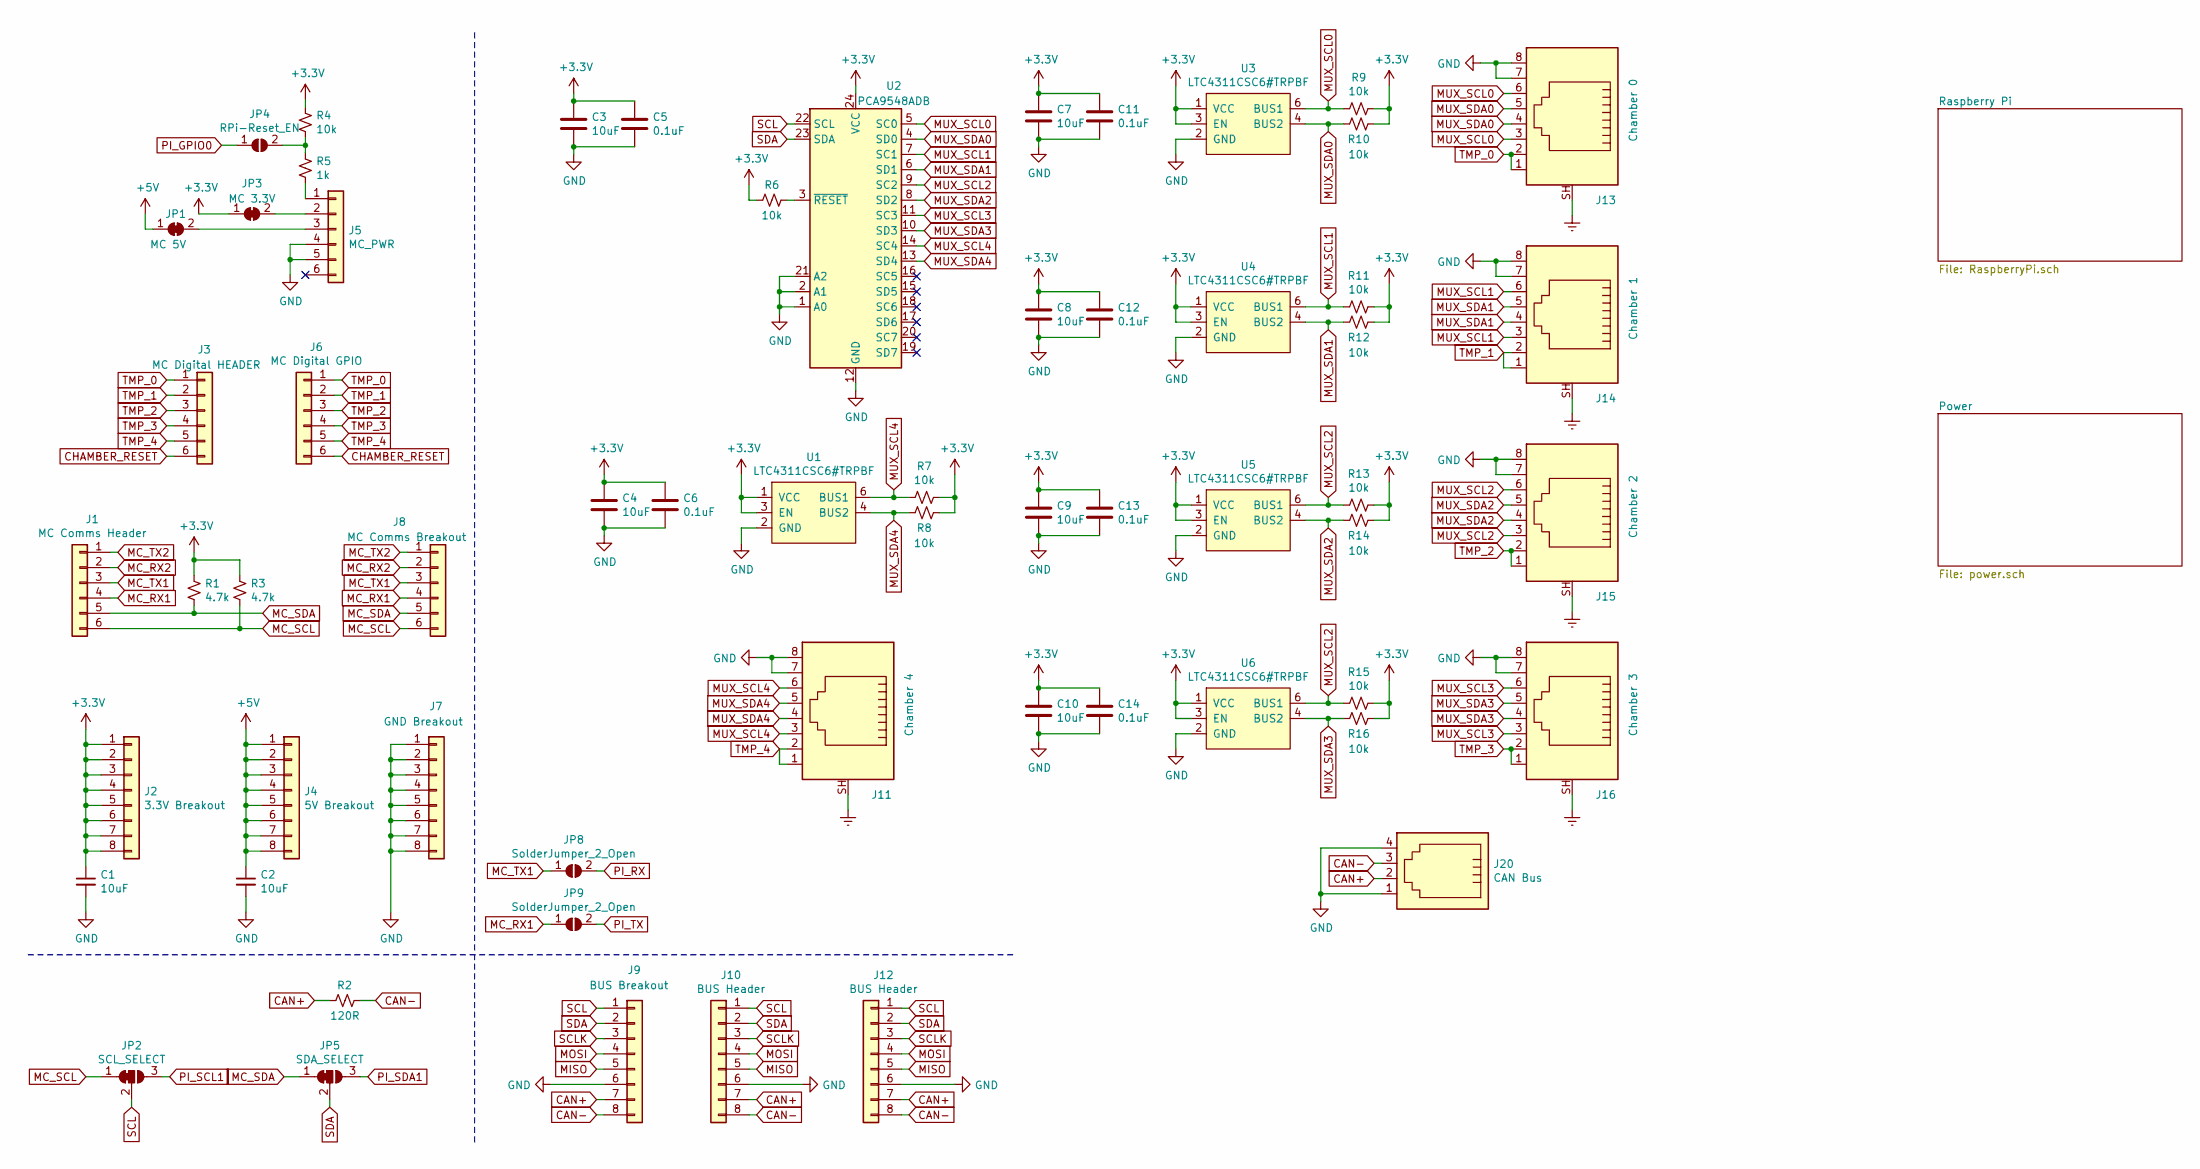
[picture p15: schematic mainboard.sch]

Parts:
C1, C2, C3, C4, C7, C8, C9, C10: 10uF; C_0603_1608Metric
C5, C6, C11, C12, C13, C14: 0.1uF; C_0603_1608Metric
J1: MC Comms Header
J2: 3.3V Breakout; PinSocket_1x08_P2.54mm_Vertical
J3: MC Digital HEADER
J4: 5V Breakout; PinSocket_1x08_P2.54mm_Vertical
J5: MC_PWR
J6: MC Digital GPIO
J7: GND Breakout; PinSocket_1x08_P2.54mm_Vertical
J8: MC Comms Breakout; PinHeader_1x06_P2.54mm_Vertical
J9: BUS Breakout; PinSocket_1x08_P2.54mm_Vertical
J10, J12: BUS Header
J11: Chamber 4; MTJ-889X1-FSE(RJ45)
J13: Chamber 0; MTJ-889X1-FSE(RJ45)
J14: Chamber 1; MTJ-889X1-FSE(RJ45)
J15: Chamber 2; MTJ-889X1-FSE(RJ45)
J16: Chamber 3; MTJ-889X1-FSE(RJ45)
J20: CAN Bus; RJ22
JP1: MC 5V; SolderJumper-2_P1.3mm_Bridged_Pad1.0x1.5mm
JP2: SCL_SELECT; SolderJumper-3_P1.3mm_Bridged12_Pad1.0x1.5mm
JP3: MC 3.3V; SolderJumper-2_P1.3mm_Bridged2Bar_Pad1.0x1.5mm
JP4: RPi-Reset_EN; SolderJumper-2_P1.3mm_Open_TrianglePad1.0x1.5mm
JP5: SDA_SELECT; SolderJumper-3_P1.3mm_Bridged12_Pad1.0x1.5mm
JP8, JP9: SolderJumper_2_Open; SolderJumper-2_P1.3mm_Open_Pad1.0x1.5mm
R1, R3: 4.7k; R_0603_1608Metric
R2: 120R; R_0603_1608Metric
R4, R6, R7, R8, R9, R10, R11, R12, R13, R14, R15, R16: 10k; R_0603_1608Metric
R5: 1k; R_0603_1608Metric
U1, U3, U4, U5, U6: LTC4311CSC6#TRPBF; SOT-363_SC-70-6
U2: PCA9548ADB; SSOP-24_5.3x8.2mm_P0.65mm

Connections:
+3V3: C1.1, C3.1, C4.1, C5.1, C6.1, C7.1, C8.1, C9.1, C10.1, C11.1, C12.1, C13.1, C14.1, J2.1, J2.2, J2.3, J2.4, J2.5, J2.6, J2.7, J2.8, JP3.1 (A), R1.1, R3.1, R4.1, R6.2, R7.1, R8.1, R9.1, R10.1, R11.1, R12.1, R13.1, R14.1, R15.1, R16.1, U1.1 (VCC), U1.3 (EN), U2.24 (VCC), U3.1 (VCC), U3.3 (EN), U4.1 (VCC), U4.3 (EN), U5.1 (VCC), U5.3 (EN), U6.1 (VCC), U6.3 (EN); also elsewhere on the board
+5V: C2.1, J4.1, J4.2, J4.3, J4.4, J4.5, J4.6, J4.7, J4.8, JP1.1 (A); also elsewhere on the board
CAN+: J9.7, J10.7, J12.7, J20.2, R2.1
CAN-: J9.8, J10.8, J12.8, J20.3, R2.2
Earth: J11.SH, J13.SH, J14.SH, J15.SH, J16.SH; also elsewhere on the board
GND: C1.2, C2.2, C3.2, C4.2, C5.2, C6.2, C7.2, C8.2, C9.2, C10.2, C11.2, C12.2, C13.2, C14.2, J5.4, J5.5, J7.1, J7.2, J7.3, J7.4, J7.5, J7.6, J7.7, J7.8, J9.6, J10.6, J11.7, J11.8, J12.6, J13.7, J13.8, J14.7, J14.8, J15.7, J15.8, J16.7, J16.8, J20.1, J20.4, U1.2 (GND), U1.5 (GND), U2.1 (A0), U2.2 (A1), U2.12 (GND), U2.21 (A2), U3.2 (GND), U3.5 (GND), U4.2 (GND), U4.5 (GND), U5.2 (GND), U5.5 (GND), U6.2 (GND), U6.5 (GND); also elsewhere on the board
MC_RX1: J1.4, J8.4, JP9.1 (A)
MC_RX2: J1.2, J8.2
MC_SCL: J1.6, J8.6, JP2.1 (A), R3.2
MC_SDA: J1.5, J8.5, JP5.1 (A), R1.2
MC_TX1: J1.3, J8.3, JP8.1 (A)
MC_TX2: J1.1, J8.1
MISO: J9.5, J10.5, J12.5
MOSI: J9.4, J10.4, J12.4
MUX_SCL0: J13.3, J13.6, R9.2, U2.5 (SC0), U3.6 (BUS1)
MUX_SCL1: J14.3, J14.6, R11.2, U2.7 (SC1), U4.6 (BUS1)
MUX_SCL2: J15.3, J15.6, R13.2, R15.2, U2.9 (SC2), U5.6 (BUS1), U6.6 (BUS1)
MUX_SCL3: J16.3, J16.6, U2.11 (SC3)
MUX_SCL4: J11.3, J11.6, R7.2, U1.6 (BUS1), U2.14 (SC4)
MUX_SDA0: J13.4, J13.5, R10.2, U2.4 (SD0), U3.4 (BUS2)
MUX_SDA1: J14.4, J14.5, R12.2, U2.6 (SD1), U4.4 (BUS2)
MUX_SDA2: J15.4, J15.5, R14.2, U2.8 (SD2), U5.4 (BUS2)
MUX_SDA3: J16.4, J16.5, R16.2, U2.10 (SD3), U6.4 (BUS2)
MUX_SDA4: J11.4, J11.5, R8.2, U1.4 (BUS2), U2.13 (SD4)
unnamed: J3.6, J6.6
unnamed: J5.1, R5.2
unnamed: J5.2, JP3.2 (B)
unnamed: J5.3, JP1.2 (B)
unnamed: JP4.2 (B), R4.2, R5.1
unnamed: R6.1, U2.3 (~RESET)
PI_GPIO0: JP4.1 (A); also elsewhere on the board
PI_RX: JP8.2 (B); also elsewhere on the board
PI_SCL1: JP2.3 (B); also elsewhere on the board
PI_SDA1: JP5.3 (B); also elsewhere on the board
PI_TX: JP9.2 (B); also elsewhere on the board
SCL: J9.1, J10.1, J12.1, JP2.2 (C), U2.22 (SCL)
SCLK: J9.3, J10.3, J12.3
SDA: J9.2, J10.2, J12.2, JP5.2 (C), U2.23 (SDA)
TMP_0: J3.1, J6.1, J13.1, J13.2
TMP_1: J3.2, J6.2, J14.1, J14.2
TMP_2: J3.3, J6.3, J15.1, J15.2
TMP_3: J3.4, J6.4, J16.1, J16.2
TMP_4: J3.5, J6.5, J11.1, J11.2
