Aerosol-Technology-Lab/IoT-Smart-Hydroponics-Greenhouse-Research/pcb/mainboard/mainboard.kicad_pcb

## KiCad design pcb/mainboard/mainboard.kicad_pcb (continued)

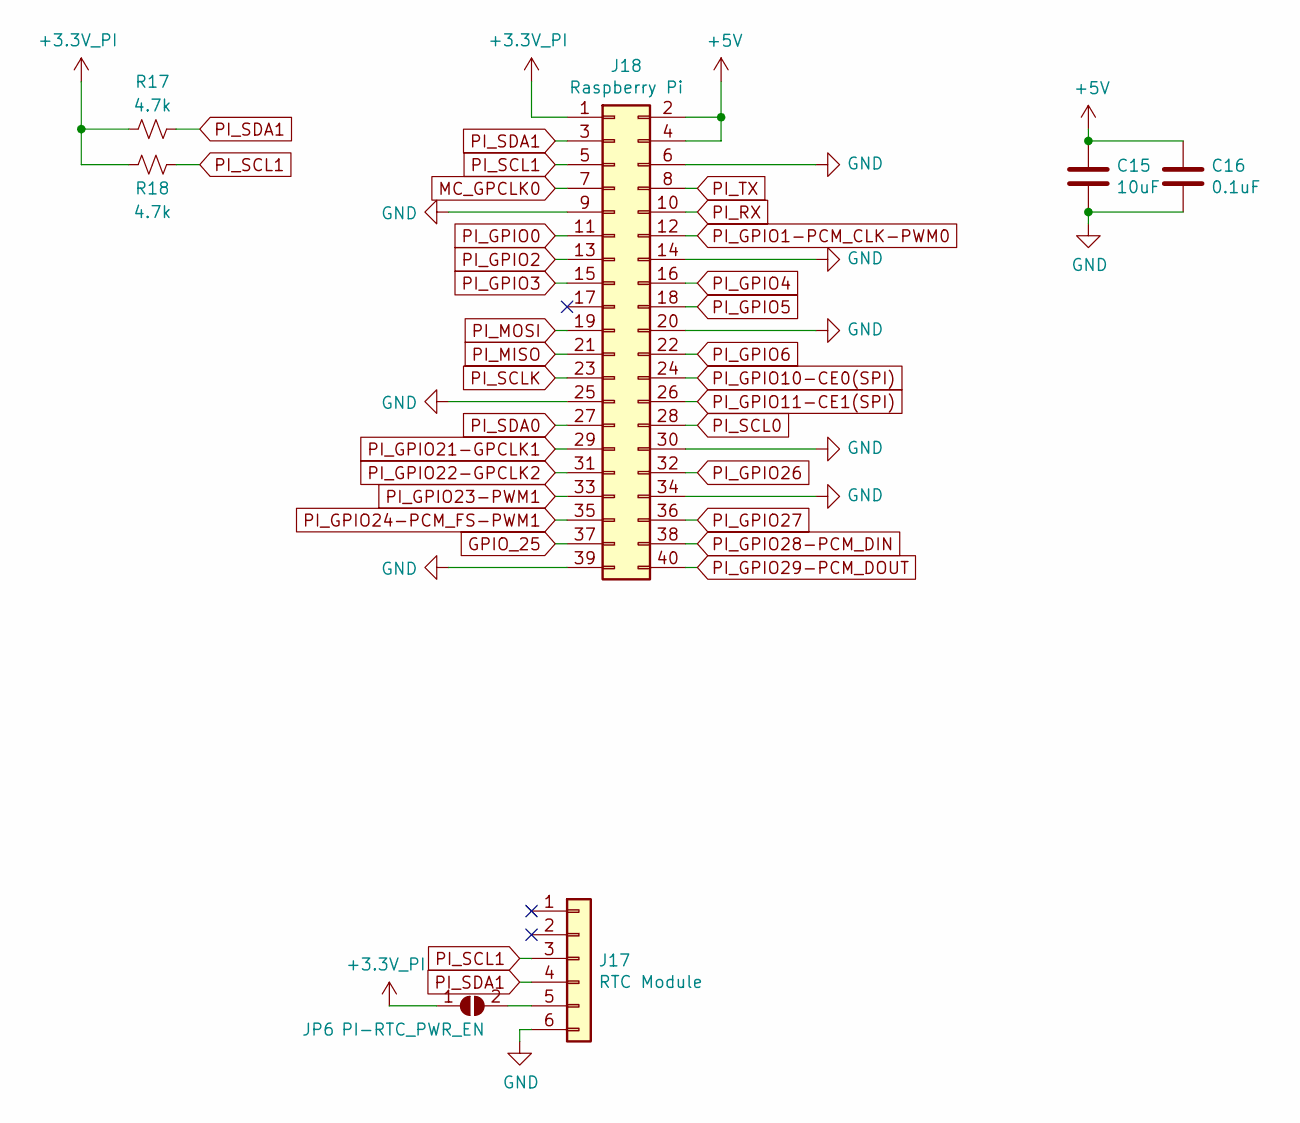
[picture p16: schematic RaspberryPi.sch]

Parts:
C15: 10uF; C_0603_1608Metric
C16: 0.1uF; C_0603_1608Metric
J17: RTC Module; PinSocket_1x06_P2.54mm_Vertical
J18: Raspberry Pi; IDC-Header_2x20_P2.54mm_Vertical
JP6: PI-RTC_PWR_EN; SolderJumper-2_P1.3mm_Open_TrianglePad1.0x1.5mm
R17, R18: 4.7k; R_0603_1608Metric

Connections:
+5V: C15.1, C16.1, J18.2, J18.4; also elsewhere on the board
GND: C15.2, C16.2, J17.6, J18.6, J18.9, J18.14, J18.20, J18.25, J18.30, J18.34, J18.39; also elsewhere on the board
GPIO_25: J18.37
MC_GPCLK0: J18.7
unnamed: J17.5, JP6.2 (B)
PI_GPIO0: J18.11; also elsewhere on the board
PI_GPIO1-PCM_CLK-PWM0: J18.12
PI_GPIO2: J18.13
PI_GPIO3: J18.15
PI_GPIO4: J18.16
PI_GPIO5: J18.18
PI_GPIO6: J18.22
PI_GPIO10-CE0(SPI): J18.24
PI_GPIO11-CE1(SPI): J18.26
PI_GPIO21-GPCLK1: J18.29
PI_GPIO22-GPCLK2: J18.31
PI_GPIO23-PWM1: J18.33
PI_GPIO24-PCM_FS-PWM1: J18.35
PI_GPIO26: J18.32
PI_GPIO27: J18.36
PI_GPIO28-PCM_DIN: J18.38
PI_GPIO29-PCM_DOUT: J18.40
PI_MISO: J18.21
PI_MOSI: J18.19
PI_RX: J18.10; also elsewhere on the board
PI_SCL0: J18.28
PI_SCL1: J17.3, J18.5, R18.1; also elsewhere on the board
PI_SCLK: J18.23
PI_SDA0: J18.27
PI_SDA1: J17.4, J18.3, R17.1; also elsewhere on the board
PI_TX: J18.8; also elsewhere on the board
~: J18.1, JP6.1 (A), R17.2, R18.2

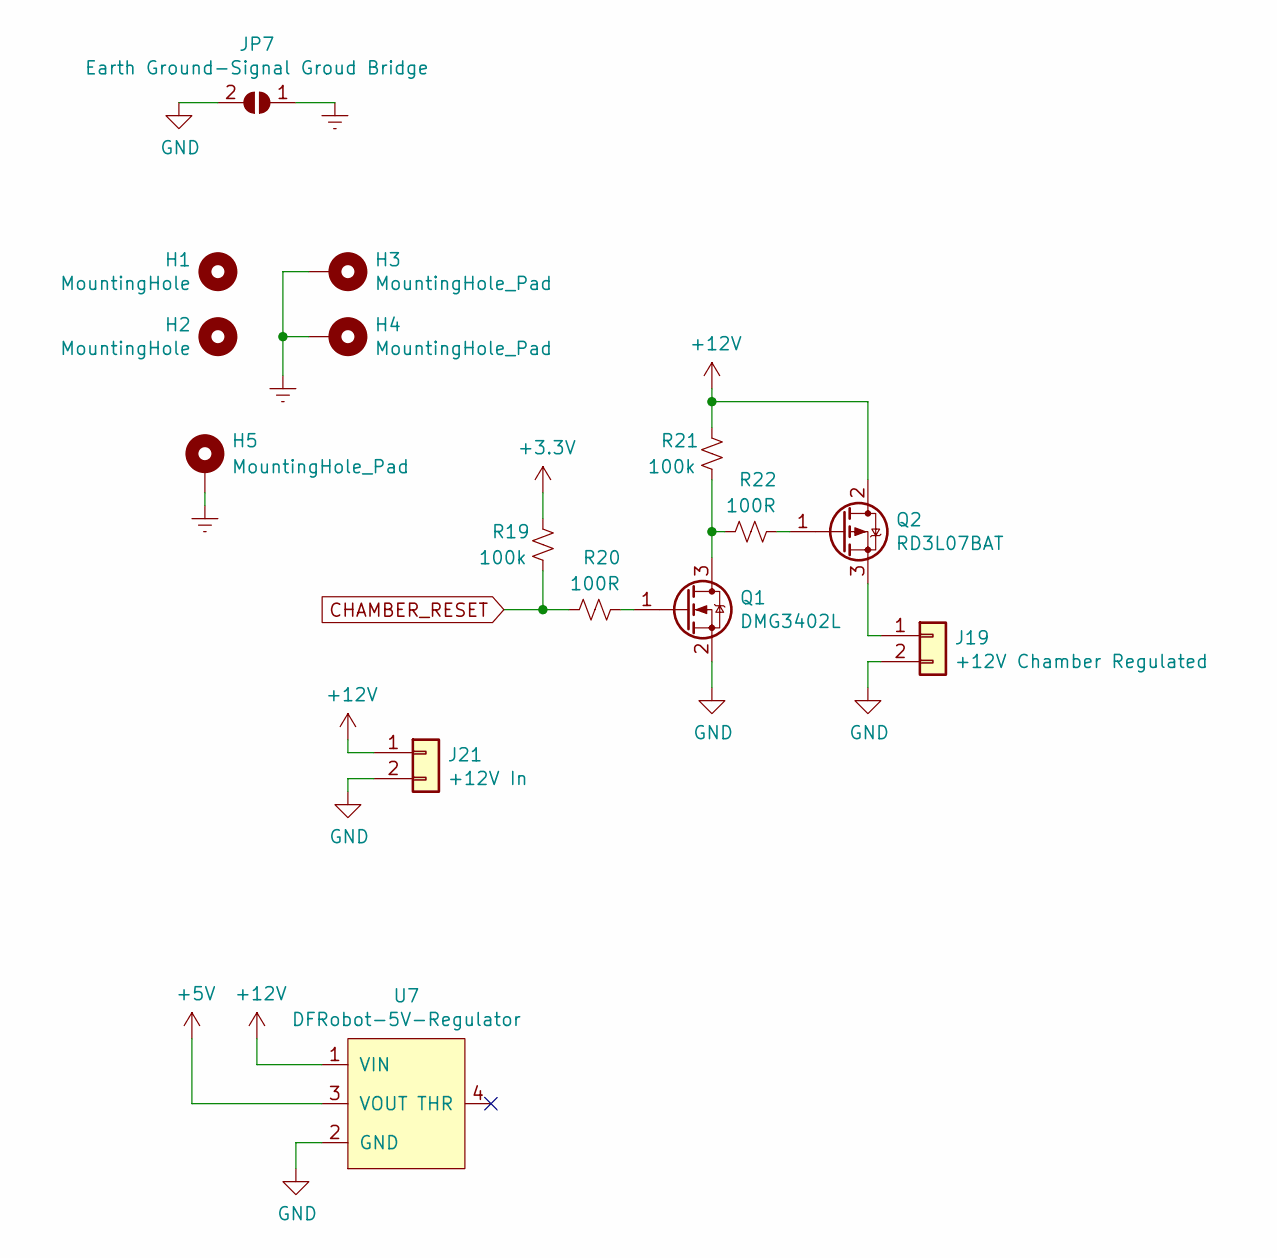
[picture p17: schematic power.sch, Power Regulator | Hydroponics Mainboard]

Parts:
H1, H2: MountingHole; MountingHole_3.2mm_M3_ISO7380_Pad_TopOnly
H3, H4, H5: MountingHole_Pad; MountingHole_3.2mm_M3_Pad_Via
J19: +12V Chamber Regulated; YK7010223000G(2POS-Terminal-Block)
J21: +12V In; YK7010223000G(2POS-Terminal-Block)
JP7: Earth Ground-Signal Groud Bridge; SolderJumper-2_P1.3mm_Open_TrianglePad1.0x1.5mm
Q1: DMG3402L; SOT-23
Q2: RD3L07BAT; TO-252-2
R19, R21: 100k; R_0603_1608Metric
R20, R22: 100R; R_0603_1608Metric
U7: DFRobot-5V-Regulator

Connections:
+3V3: R19.1; also elsewhere on the board
+5V: U7.3 (VOUT); also elsewhere on the board
+12V: J21.1, Q2.2 (D), R21.1, U7.1 (VIN)
CHAMBER_RESET: R19.2, R20.2
Earth: H3.1, H4.1, H5.1, JP7.1 (A); also elsewhere on the board
GND: J19.2, J21.2, JP7.2 (B), Q1.2 (S), U7.2 (GND); also elsewhere on the board
unnamed: J19.1, Q2.3 (S)
unnamed: Q1.1 (G), R20.1
unnamed: Q1.3 (D), R21.2, R22.2
unnamed: Q2.1 (G), R22.1

Board: 2 copper layers, 75 parts (0 on the bottom side), 42 nets, no tracks yet.
