Aerosol-Technology-Lab/IoT-Smart-Hydroponics-Greenhouse-Research/Arduino Sensor Controller/src/PH.h

#pragma once

#include "SensorInterface.h"
#include <stdint.h>
#include "utils.h"
#include "DFRobot_PH.h"
#include "WaterTemperature.h"

class PH : public SensorInterface
{
private:
    uint8_t pin;
    DFRobot_PH sensor;
    WaterTemperature *temp;
    
public:
    PH();

    PH(uint8_t pin, WaterTemperature *temp=nullptr, bool initialize=true);

    void init();
    
    /**
     * @brief returns ph reading
     * 
     * @param _ unused
     * @return float ph reading
     */
    float read(uint8_t _=0);

    size_t write(char *buffer, uint8_t idx=0);

    virtual float readTemp();
};
