Aerosol-Technology-Lab/IoT-Smart-Hydroponics-Greenhouse-Research/Arduino Sensor Controller/src/TDS.cpp

#include "TDS.h"
#include <stdint.h>
#include <stdlib.h>
#include "utils.h"

TDS::TDS(uint8_t pin, WaterTemperature *temp, bool initialize)
    : pin(pin),
      temp(temp)
{
    if (initialize) {
        init();
    }
}

void TDS::init()
{
    if (!initialized) {
        pinMode(pin, INPUT);
        initialized = true;
    }
}

float TDS::read(uint8_t idx)
{
    for (int i = 0; i < SCOUNT; ++i) {
        analogBuffer[i] = analogRead(pin);
    }

    averageVoltage = getMedianNum(analogBuffer, SCOUNT) * VREF / ANALOG_RESOLUTION; // read the analog value more stable by the median filtering algorithm, and convert to voltage value
    float compensationCoefficient = 1.0f + 0.02f * (temperature - readTemp());    //temperature compensation formula: fFinalResult(25^C) = fFinalResult(current)/(1.0+0.02*(fTP-25.0));
    float compensationVolatge = averageVoltage / compensationCoefficient;  //temperature compensation
    return (133.42f * compensationVolatge * compensationVolatge * compensationVolatge - 255.86f * compensationVolatge * compensationVolatge + 857.39f * compensationVolatge ) * 0.5f; //convert voltage value to tds value
}

size_t TDS::write(char *buffer, uint8_t _) {

    float tds = read();
    sprintf(buffer, "TDS %d", (int)(tds + 0.5f));
    return strlen(buffer) + 1;
}

void TDS::setTemperatureSensor(WaterTemperature *temp)
{
    this->temp = temp;
}

float TDS::readTemp()
{
    if   (!temp) return 25.0f;        // no temperature sensor given, just use default value
    else return temp->read();
}

// todo: move this to utils
// note: if avg is true, there is a floating point division. There is a no rounding
// cast from float to int
int TDS::getMedianNum(int bArray[], int iFilterLen)
{
    Utils::quickSort(bArray, 0, iFilterLen - 1);
    int mid = iFilterLen / 2;
    bool avg = !(iFilterLen % 2);
    return avg ? (bArray[mid - 1] + bArray[mid]) / 2.0f : bArray[mid];
}
