Aerosol-Technology-Lab/IoT-Smart-Hydroponics-Greenhouse-Research/(commit log)

2021-02-20 Cursor appearance disabled when on raspberry pi
2021-02-21 Improve error handling on Arduino connection
2021-02-22 Create autoupdate script for Raspberry Pi, updating code and allow updating and start at boot time
2021-02-23 Styling and add temperature support
2021-02-23 Preparing for more sensors
2021-02-23 Add focus when a navigation button is pressed
2021-02-23 Change architecture detection for Raspberry Pi
2021-02-26 Update compile flags for different boards on build
2021-03-01 Add command to poll all data from sensors
2021-03-02 Add a way to add more temperature sensors when needed
2021-03-03 Add i2c mux helper header
2021-03-03 Refactor temperature functions to waterTemperature for clarity
2021-03-04 Implement bme280 sensors
2021-03-04 Add insertion of rows into database
2021-03-05 Fix bug when requesting bme sensor index higher than 0 will label the reading as sensor 0
    [sensors.cpp]
2021-04-05 Reading temperature sensors depends on constant instead of hard code
2021-04-05 Add water temprature sensor wrapper
2021-04-05 Integrated water temperatue sensor
2021-04-05 Finish TDS sensor
2021-04-06 Modify DFRobot PH library to add Arduino DUE compatibility
2021-04-06 Modify DFRobot library to accomodate differences between Arduino Due and the Uno
2021-04-07 Modify water temperature default initialization action
2021-04-07 Implement TDS sensor and buffer
2021-06-15 Add additional sensor code
2021-06-15 Add reading ambient light sensor
2021-06-15 Add documentation and enabled reading water temperature at main
2021-06-16 Fix new system to send data to arduino
    [main.cpp, utils.cpp, utils.h]
2021-06-16 Fix bug where calling ambient light sensor instead called the water temperature sensor
    [main.cpp]
2021-06-18 Add simulation compatibility for ESP32 and fixed issues with recognizing commands
    [main.cpp, simulator.cpp]
2021-09-02 Can talk to Arduino
2021-09-11 Add checks for raspberry pi usb
2021-09-11 Reduced font size to increase readability for Raspberry Pi
2021-09-11 Fix overflow in chamber
2021-09-13 Fix various bugs related to wrong use of I2C mux
    [WaterTemperature.cpp, main.cpp, sensors.cpp, sensors.h]
2021-09-13 Add reset request to sensor board
    [main.cpp]
2021-09-14 Add support for ccs811 (CO2 and TVOC) sensor
2021-09-14 Add functionality for turbidity sensor
2021-09-14 Remove deprecated PH sensor
2021-09-14 Remove call for deprecated PH sensor function in main
2021-09-15 Fix refactor in cpp file
    [sensors.cpp]
2021-09-15 Bug fixes with wrong voltage conversion to the external sensors
    [EC.h, PH.h, TDS.cpp]
2021-09-15 Add support for sensors wrapper for all external sensors
2021-09-17 Add functionality to read from more peripheral devices
2021-10-02 Moved reset functionality to utils file
    [main.cpp, utils.h]
2021-10-02 Bug fixes and added several senso functionality
    [sensors.cpp, sensors.h]
2021-10-02 Add routine for calibrating peripheral sensors
2022-01-27 Add pcb
    [022053031.stp, 2035551012.step, 5054133410.stp, 955016449.stp, MTJ-889X1-FSE.stp, Power.sch, RaspberryPi.sch, chamber-board.csv]
2022-02-17 Add pcb files
2022-02-17 Fix issues after upgrading to new pcb
    [main.cpp, sensors.cpp, sensors.h, utils.h]
2022-03-05 Separte I2C sensor initialization to separate callable functions
2022-03-05 Disable CCS811 sensor for testing purposes
2022-03-05 Refactor i2cmux to i2cmux_access_chamber -> makes more sense in the context of function purpose
2022-03-05 Update README for Raspberry Pi codebase
2022-03-06 Change the method for determining if the sensor reading is valid from the frontend to new method -> less prone to issues
